csdnaokdm/FOC/选型报告/电容封装与直流偏压选型参考.md

# 电容封装与直流偏压选型参考

**适用场景**　FOC 底板的 3.3 V、5 V、12 V 电源。15 V 用作母线偏压对比工作点。

## 常见容值从什么封装起选

**0603 优先用于 pF 到 100 nF 的小电容和高频旁路，0805 优先用于 12 V 上的 1 µF，以及 3.3 V、5 V 上的几 µF 去耦。** 12 V 上若要得到接近 10 µF 的有效容量，先比较 1206、1210 或多颗并联的方案。表里的封装是选型起点，每个具体料号仍要按工作偏压读曲线。

| 标称容值 | 3.3 V / 5 V 上的常用起点 | 12 V 母线及 15 V 参考点的常用起点 | 主要用途与选型重点 |
|---|---|---|---|
| **10–100 pF** | 0603 C0G/NP0 | 0603 C0G/NP0，另核耐压和瞬态 | 晶振负载、精密滤波、匹配。容量随电压和温度变化很小 |
| **220 pF–10 nF** | 0603 C0G 或 X7R | 0603，耐压或容量规格难找时看 0805 | ADC 输入 RC、信号滤波。截止频率或相位有精度要求时优先 C0G |
| **22–100 nF** | 0603 X7R | 0603 X7R，50 V 型号可作起点 | 芯片脚旁高频旁路。100 nF / 50 V 的 C1591 在 12 V 下仍约有 93 nF |
| **220–470 nF** | 0603 X7R/X5R | 0603 或 0805 X7R，优先找有曲线的型号 | 局部去耦与自举候选。自举按电容两端的差分电压和所需电荷选值 |
| **1 µF** | 0603 可先筛，需接近 1 µF 时看 0805 | **0805 X7R 起选**。C28323 在 12 V 下约有 0.85 µF | 局部去耦、自举或多颗并联。相同的 1 µF / 50 V 标称值也可能有很不同的减容 |
| **2.2–4.7 µF** | 0805 X7R/X5R 起选。0603 可用于允许减容的局部去耦 | 0805 按型号筛。若有效容量有明确下限，优先比较 1206 或并联 | 稳压输入、负载旁路。项目旧料 2.2 µF / 0603 在 5 V 下约剩 1.03 µF，在 12 V 下约剩 0.40 µF |
| **10 µF** | 0805 可用于允许一定减容的就近去耦。若需要接近标称值，比较 1206、1210 或并联 | **1206 / 1210 起选并核曲线**。本次核过的两颗 50 V 0805 单颗在 12 V 下约为 2.6–2.8 µF | 电源局部储能、MOS 桥旁滤波。耐压相同也要比较工作点容量 |
| **22–47 µF** | 1206 / 1210 起选。稳压输出需同时满足有效容量和 ESR 要求 | 1210、较大封装或多颗并联，按偏压、纹波和温升选 | Buck 输出和较低频储能。大标称值的 0603/0805 需要型号曲线支持 |
| **100–470 µF 及以上** | 看铝电解、聚合物或合适的钽电容 | 母线大容量储能通常用铝电解，功率桥附近另布陶瓷滤波 | 按耐压、ESR、纹波电流、寿命、极性和实物尺寸选 |

0603、0805、1206、1210 在本文均为英制封装，分别约 **1.6 × 0.8、2.0 × 1.25、3.2 × 1.6、3.2 × 2.5 mm**。厚度和端头尺寸按所选型号核对。较小封装可缩短高频回路，较大封装通常有更多实现有效容量的空间。最终同时看容量、阻抗和走线。 [三星 MLCC 规格目录](https://product.samsungsem.com/resources/file/product-catalog/MLCC_2401.pdf) · [TI 陶瓷电容选型与纹波](https://www.ti.com/document-viewer/lit/html/SSZTBI6)

## 原厂曲线对比

下表是单颗典型有效容量，单位均为 **µF**，按 `标称容量 × (1 + ΔC% / 100)` 换算。曲线基于约 25°C 的数据。已有项目曲线按数据点插值，三星新增 10 µF / 0805 按图读数，村田按 SimSurfing 曲线换算。曲线读数尚需叠加初始容差、实际温度、老化和测量条件。5 V 输出的 22 µF 料使用 120 Hz、0.5 Vrms 曲线，其余三星样例为 1 kHz、1 Vrms，村田曲线显示 25°C、1 Vrms。

| 标称值 / 封装 / 介质 / 耐压 | 厂家型号与立创编号 | 3.3 V | 5 V | 12 V | 15 V |
|---|---|---:|---:|---:|---:|
| 100 nF / 0603 / X7R / 50 V | 三星 [CL10B104KB8NNNC](https://product.samsungsem.com/mlcc/CL10B104KB8NNN.do) · C1591 | 0.101 | 0.100 | 0.093 | 0.089 |
| 1 µF / 0603 / X5R / 50 V | 三星 [CL10A105KB8NNNC](https://product.samsungsem.com/mlcc/CL10A105KB8NNN.do) · C15849 | 0.816 | 0.656 | 0.290 | 0.218 |
| 1 µF / 0805 / X7R / 50 V | 三星 [CL21B105KBFNNNE](https://product.samsungsem.com/mlcc/CL21B105KBFNNN.do) · C28323 | 0.998 | 0.975 | **0.853** | 0.796 |
| 2.2 µF / 0603 / X5R / 25 V | 三星 [CL10A225KA8NNNC](https://product.samsungsem.com/mlcc/CL10A225KA8NNN.do) · C57895 | 1.442 | 1.026 | 0.395 | 0.295 |
| 2.2 µF / 1206 / X7R / 50 V | 三星 [CL31B225KBHNNNE](https://product.samsungsem.com/mlcc/CL31B225KBHNNN.do) · C50254 | 2.218 | 2.173 | 1.911 | 1.786 |
| 4.7 µF / 1206 / X7R / 50 V | 三星 [CL31B475KBHNNNE](https://product.samsungsem.com/mlcc/CL31B475KBHNNN.do) · C51205 | 4.698 | 4.546 | 3.720 | 3.338 |
| 10 µF / 0805 / X5R / 50 V | 村田 [GRM21BR61H106KE43L](https://item.szlcsc.com/439567.html) · C440198 | 8.00 | 6.41 | **2.62** | 2.04 |
| 10 µF / 0805 / X5R / 50 V | 三星 [CL21A106KBYQNNE](https://product.samsungsem.com/mlcc/CL21A106KBYQNN.do) · C2932476 | — | — | **约 2.8** | 约 2.2 |
| 10 µF / 1206 / X7R / 50 V | 三星 [CL31B106KBHNNNE](https://product.samsungsem.com/mlcc/CL31B106KBHNNN.do) · C89632 | 9.625 | 8.505 | 4.646 | 3.644 |
| 10 µF / 1210 / X7R / 50 V | 三星 [CL32B106KBJNNNE](https://product.samsungsem.com/mlcc/CL32B106KBJNNN.do) · C138687 | 9.790 | 9.393 | **7.413** | 6.553 |
| 22 µF / 1206 / X5R / 25 V | 三星 [CL31A226KAHNNNE](https://product.samsungsem.com/mlcc/CL31A226KAHNNN.do) · C12891 | 17.485 | 13.648 | 5.729 | 4.251 |
| 22 µF / 1210 / X5R / 25 V | 三星 [CL32A226KAJNNNE](https://product.samsungsem.com/mlcc/CL32A226KAJNNN.do) · C52306 | 20.387 | **17.486** | 8.946 | 6.924 |

同是 **10 µF / 50 V**，12 V 偏压下村田 0805 约剩 **26%**，三星 1210 约剩 **74%**。两颗该村田 0805 并联也只有约 **5.24 µF**。按 12 V 的典型容量对比，三颗约 **7.86 µF**，到 15 V 时三颗约 **6.13 µF**。若把 C138687 当作对照，应按实际工作电压分别比较，并留出容差与温度裕量。 [村田原厂 SimSurfing 曲线](https://ds.murata.com/simsurfing/mlcc.html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) · [三星 1210 原厂曲线](https://product.samsungsem.com/mlcc/CL32B106KBJNNN.do)

原始数据可查[项目已有型号的原厂曲线与计算记录](资料/2026-11-12_电容/本次确认与替代方案.json)和 [100 nF 曲线记录](资料/2026-11-12_电容/100nF_50V_C1591_原厂DC数据.json)。三星 50 V 0805 的 [立创商品页](https://www.lcsc.com/product-detail/C2932476.html)可核对完整型号。

## 各类电容的特性

| 类型 | 电气与使用特性 | 适合的位置 |
|---|---|---|
| **C0G / NP0 陶瓷** | 无极性，低损耗，直流偏压和老化对容量的影响很小。C0G 的常见温度系数规格为 0 ±30 ppm/°C。常见小封装容量集中在 pF 到 nF 级 | 晶振、精密 RC、滤波和匹配 |
| **X7R 陶瓷** | 无极性，体积小，ESR 和 ESL 通常较低。温度特性为 −55～125°C、相对基准容量 ±15%。工作时还要计入直流偏压和老化 | 12 V 母线旁路、驱动自举、靠近发热器件的电源去耦 |
| **X5R 陶瓷** | 无极性，常见高容值系列多。温度特性为 −55～85°C、±15%。直流偏压下的容量由型号曲线决定 | 3.3 V、5 V 去耦和空间受限的电源滤波 |
| **X6S、Y5V 等高介电陶瓷** | X6S 为 −55～105°C、±22%，Y5V 的温度容量变化范围更宽。可做出较大标称容值，选型时需同时看温度曲线和偏压曲线 | 允许容量变化、且原厂曲线满足电路下限的旁路或储能 |
| **固体钽（MnO₂）** | 有极性，容量密度高，偏压变化通常较小。ESR 取决于系列，对反接、浪涌和过压敏感，按厂商规则降额 | 有输出电容类型或 ESR 要求的 LDO。本板 3.3 V 输出选 22 µF / 10 V A 型钽 **C11366**，按 LDO 手册和实测确认稳定性。 [UMW 手册](https://atta.szlcsc.com/upload/public/pdf/source/20241218/BAF0263FA2E44BCD8AF41AA4FA04EFAA.pdf) |
| **铝电解** | 通常有极性。大容量容易取得。ESR 随频率、温度和寿命变化，纹波电流引起自热。额定纹波需按测试频率及温度修正 | 12 V 入口和母线储能。本板使用 100 µF / 35 V **C2887272** 与 470 µF / 35 V **C72519** |
| **导电聚合物铝电解或钽电容** | 常用贴片型号有极性，通常具有更低 ESR 和较好的纹波能力。需核对耐压、漏电和稳压器对 ESR 的要求 | 低阻抗储能、开关电源输出和较大负载阶跃。 [Panasonic OS-CON 系列](https://industrial.panasonic.com/ww/products/pt/os-con/lineup) |
| **薄膜电容** | 多数无极性，低损耗，容量随偏压变化小，体积通常较大。不同介质的脉冲和温度特性不同 | 脉冲、谐振和需要容量稳定的场合。 [WIMA 薄膜介质特性](https://www.wima.de/en/service/knowledge-base/dielectric/) |

介质温度代码描述规定条件下的温度变化。初始容差、工作偏压、老化和交流测试幅度需要单独核对。ESR 影响纹波和自热，ESL 与布局决定高频阻抗。靠近 MOS 桥或 Buck 的陶瓷电容要缩短供电和回地之间的高频回路。 [村田陶瓷类型说明](https://www.murata.com/en-global/support/faqs/capacitor/ceramiccapacitor/char/0017) · [TDK 温度代码](https://product.tdk.com/en/contact/faq/capacitors-0051.html) · [KYOCERA AVX TAJ 系列](https://www.kyocera-avx.com/products/tantalum/smd-tantalum-mno2/taj-series/) · [Nichicon 铝电解应用指南](https://www.nichicon.co.jp/english/products/pdf/aluminum-e.pdf) · [TI 电源电容阻抗和布局](https://www.ti.com/document-viewer/lit/html/ssztal7)

## 以后选料时怎么核算

1. 先看芯片手册或电路计算所需的有效容量、ESR 和纹波条件。Buck 输入、Buck 输出和 LDO 输出各自核对。
2. 用电容两端的实际直流电压查完整料号。自举电容按 `VBx−VSx`，12 V 母线按实际母线偏压，耐压另计尖峰和使用温度。
3. 先对比厂家曲线的典型值，再按初始容差、温度、老化等条件预留余量。并联时，同一偏压下的有效容量相加，纹波分担取决于器件阻抗和布局。
