csdnaokdm/FOC/选型报告/选型报告.md

# FOC 硬件选型报告

**阿波罗 H7 V2.5 核心板 · 2804 电机 · 12 V 台架**  
更新：2026-11-12

本报告按使用位置和器件类别整理当前方案。电容用“12 V→5 V 输入”“5 V 输出”“MOS 母线滤波”等位置描述；表中的商城采购编号用于买料，与原理图位号分开。当前记录的电源条件是 **12 V**，后面的 **15 V 只作为电容减容参考工作点**。

采购状态分为“已确认”“本次推荐”和“待确认”。本次更新整理选型与采购信息，未操作原理图、PCB 和封装。旧方案与旧料号对比见[历史料号](历史料号.md)，原报告全文保存在[历史方案 v0.4](历史方案_2026-11-05_v0.4.md)。

## 1. 芯片

### 1.1 电源芯片

| 使用位置 | 当前型号与采购编号 | 主要参数 | 国内含税首档单价 / 起卖量 | 状态与落实事项 |
|---|---|---|---|---|
| 12 V→5 V 降压 | **TI LMR51430XDDCR**；[C5185863](https://item.szlcsc.com/5856347.html) | 同步 Buck；输入 4.5–36 V；标称输出能力 3 A；500 kHz；SOT-23-6 | **¥4.79/个；1 个起卖**；最低货款 ¥4.79；查询时现货 7,676 个 | 当前原理图已使用。实际连续输出能力需结合电感、电容、铜皮散热和负载确认 |
| 5 V→3.3 V 线性稳压 | **UMW（友台）AMS1117-3.3**；[**C347222**](https://item.szlcsc.com/323882.html) | 固定 3.3 V LDO；标称 1 A；SOT-223；1 A 时压差典型 1.2 V、最大 1.3 V；−40～125°C | **¥0.2971/个；10 个起卖**；最低货款约 ¥2.97；100+ ¥0.235，300+ ¥0.203；现货 894,290 个 | 用户已确认采购编号。原理图已使用 AMS1117-3.3 名称，具体采购参数尚需填入；实际电流能力取决于散热，功耗按 (5−3.3)×负载电流估算 |

12 V→5 V 输入的陶瓷电容按已确认方案采用 **两颗 1 µF / 50 V / 0805 并联**。相应的有效容量和采购信息见第 2 节。

3.3 V 稳压器已按用户补充的 **C347222** 核定为 UMW 产品。[UMW 原厂手册第 4～5 页](https://atta.szlcsc.com/upload/public/pdf/source/20241218/BAF0263FA2E44BCD8AF41AA4FA04EFAA.pdf)要求输出电容以保证稳定性，并给出 **22 µF 钽电容**配置，固定输出典型电路为输入 10 µF、输出 22 µF。因此本报告推荐的 **22 µF / 10 V / A 型钽电容**有对应厂家手册依据。布局时还需按输入 10 µF 的参考配置核对 LDO 就近输入储能和连接路径；5 V 输出已有大容量电容能否兼作输入储能，取决于实际位置与走线。该输入要求属于 5 V→3.3 V 级。

### 1.2 栅极驱动与控制相关芯片

| 使用位置 | 当前型号 | 当前状态 | 采购与核对事项 |
|---|---|---|---|
| 三相桥栅极驱动 | **SD6287** | 当前原理图已放置；符号记录为 TSSOP-20 | 厂家、完整后缀、采购编号、价格及起卖量待确认。需用实际器件手册核对供电、输入逻辑、欠压行为、自举要求和引脚 |
| 主控 | **正点原子阿波罗 H7 V2.5 核心板** | 已有核心板，底板按接口对接 | 核对实物版本、核心板连接器和电源引脚；不把旧报告中的单颗 MCU 预算作为本次采购项 |
| 电机角度检测 | **现有 AS5600 编码器/模块** | 保留已有器件作为调试方案 | 模块供电、输出接口及接插件线序按实物确定；本次未新增编码器芯片采购 |

三相桥 MOSFET 已由用户选定为 AOS AOD4184A（C99124），详见第 4 节。电流采样放大器及硬件保护器件的选型待落实。

## 2. 电容

### 2.1 按使用位置列出的当前选型

| 使用位置 | 容值 / 耐压 / 封装 / 类型 | 厂家完整型号 | 商城采购编号 | 每板数量与状态 |
|---|---|---|---|---|
| **12 V→5 V 输入** | **1 µF / 50 V / 0805 / X7R / ±10%** | Samsung **CL21B105KBFNNNE** | [**C28323**](https://item.szlcsc.com/29074.html) | **2 颗并联，用户已确认**；合计标称 2 µF |
| **三相栅极驱动自举** | **1 µF / 50 V / 0805 / X7R / ±10%** | Samsung **CL21B105KBFNNNE** | [**C28323**](https://item.szlcsc.com/29074.html) | 每相 1 颗，共 3 颗；共用同一种料。最终容量要求随 SD6287 实际手册核对 |
| **MOS 母线滤波，靠近功率桥** | **10 µF / 50 V / 1210 / X7R / ±10%** | Samsung **CL32B106KBJNNNE** | [**C138687**](https://item.szlcsc.com/150006.html) | **本次推荐**；你已允许 MOS 区域用 1210。颗数随三相桥布局确定，暂不虚列数量 |
| **5 V 输出** | **22 µF / 25 V / 1210 / X5R / ±10%** | Samsung **CL32A226KAJNNNE** | [**C52306**](https://item.szlcsc.com/53320.html) | **本次推荐 2 颗并联**，合计标称 44 µF；需为 1210 落实焊盘和空间 |
| **5 V→3.3 V 稳压器的 3.3 V 输出** | **22 µF / 10 V / A 型 3216 / 有极性固体钽 / ±10%** | KYOCERA AVX **TAJA226K010RNJ** | [**C11366**](https://item.szlcsc.com/11919.html) | **本次推荐，1 颗**。与 UMW 手册的 22 µF 钽电容类型和标称容量一致；具体 ESR、上电和负载阶跃稳定性仍需核对 |
| **12 V 电源入口储能** | **100 µF / 35 V / Ø6.3×5.4 mm / 铝电解 / ±20%** | KNSCHA 科尼盛 **VT100UF35V34RV0158** | [**C2887272**](https://item.szlcsc.com/3103840.html) | **保留，2 颗**。纹波额定值 90 mA @120 Hz；实际开关纹波能力另核 |
| **12 V 母线大容量储能** | **470 µF / 35 V / Ø10×10.2 mm / 铝电解 / ±20%** | ROQANG 容强 **RVT1V471M1010** | [**C72519**](https://item.szlcsc.com/73630.html) | **保留，2 颗**。纹波额定值 286 mA @120 Hz；105°C、2000 h |
| **电源高频旁路与 Buck 自举参考用料** | **100 nF / 50 V / 0603 / X7R / ±10%** | Samsung **CL10B104KB8NNNC** | [**C1591**](https://item.szlcsc.com/1943.html) | **可追溯的通用参考料，不要求额外采购**。已有 100 nF 可继续按具体型号、耐压和工作点核对 |

1 µF 目前明确的用量合计 **5 颗/板**：降压输入 2 颗、三相驱动自举 3 颗。驱动电源最终需要的额外旁路，待实际驱动器手册确定后再计入。

铝电解用于储能和较低频率的母线纹波，靠近功率桥的陶瓷电容用于减小高频换流回路。两类电容的布局和纹波要求分别核对。钽电容必须按正负极及专用焊盘安装，A 型 3216 不能仅凭外形尺寸套用普通无极性陶瓷电容焊盘。

### 2.2 在本板工作电压下，实际约剩多少容量

下列陶瓷电容数值来自 **Samsung 对应型号的原厂典型 DC 偏压曲线**，按工作电压插值。它们是常温、小信号条件下的典型参考值；尚未叠加初始容差、温度、老化和批次差异，也不是保证下限。并联总容量按相同工作电压下的单颗典型值相加。

| 使用位置与选型 | 电容两端的直流电压 | 单颗典型有效容量 | 相对标称的变化 | 本位置典型总有效容量 |
|---|---:|---:|---:|---:|
| **12 V→5 V 输入：1 µF / 50 V / 0805 / X7R，C28323** | **12 V** | **约 0.853 µF** | **下降约 14.70%** | **2 颗约 1.706 µF** |
| 同一降压输入选型，15 V 参考工作点 | **15 V** | **约 0.796 µF** | **下降约 20.38%** | **2 颗约 1.592 µF** |
| **三相驱动自举：1 µF / 50 V / 0805 / X7R，C28323** | 自举电容两端若为 **12 V** | **约 0.853 µF** | **下降约 14.70%** | 每相各约 0.853 µF，三相不相加作为同一相容量 |
| **MOS 母线滤波：10 µF / 50 V / 1210 / X7R，C138687** | **12 V** | **约 7.413 µF** | **下降约 25.87%** | 按最终并联颗数乘以 7.413 µF |
| 同一 MOS 母线滤波选型，15 V 参考工作点 | **15 V** | **约 6.553 µF** | **下降约 34.47%** | 按最终并联颗数乘以 6.553 µF |
| **5 V 输出：22 µF / 25 V / 1210 / X5R，C52306** | **5 V** | **约 17.486 µF** | **下降约 20.52%** | **2 颗约 34.971 µF** |
| **3.3 V 输出推荐：22 µF / 10 V / A 型钽，C11366** | **3.3 V** | **本次未取得该具体型号的偏压有效容量数值** | 不套用陶瓷电容的减容百分比 | 按标称 22 µF、±10% 选型，与已核 UMW 手册的钽电容配置一致；手册未给数值 ESR 稳定窗口，具体型号的稳定性仍需实测 |
| **12 V 入口储能：100 µF / 35 V / 铝电解，C2887272** | **12 V** | 本次未取得该型号工作点实测值 | 不套用 X5R/X7R 陶瓷曲线 | 2 颗合计标称 200 µF；还需计入 ±20% 容差、温度、频率及寿命影响 |
| **12 V 母线储能：470 µF / 35 V / 铝电解，C72519** | **12 V** | 本次未取得该型号工作点实测值 | 不套用 X5R/X7R 陶瓷曲线 | 2 颗合计标称 940 µF；还需计入 ±20% 容差、温度、频率及寿命影响 |

降压输入按两颗 1 µF 执行时，**标称总容量是 2 µF，12 V 下典型约 1.71 µF**。这项方案已按你的要求记录；是否满足实际输入纹波和瞬态要求，仍需结合 TI 手册、输入线路及板上测量确认。5 V 输出的 22 µF 选型按 **5 V 工作点**使用，后续换位置时要重新核算偏压。

自举电容计算的是 **自举上端与对应开关相点之间的电压**，不能直接用该上端相对地的波形电压代替。三相驱动器最终供电确定后再核实际工作点；Buck 的 100 nF 自举也按同样的差分电压原则核对。

### 2.3 100 nF 常用电容也会减容吗

**会，X5R/X7R 陶瓷电容同样存在 DC 偏压效应。** 下降多少取决于具体型号。以本报告可追溯的 **100 nF / 50 V / 0603 / X7R，C1591** 为例：

| 使用位置示例 | 两端直流电压 | 典型有效容量 | 相对标称变化 |
|---|---:|---:|---:|
| 3.3 V 高频旁路 | 3.3 V | 约 **101.07 nF** | 约 **+1.07%** |
| 5 V 高频旁路 | 5 V | 约 **100.24 nF** | 约 **+0.24%** |
| 12 V 电源高频旁路 | 12 V | 约 **93.03 nF** | 约 **−6.97%** |
| 15 V 参考工作点 | 15 V | 约 **88.96 nF** | 约 **−11.04%** |

这款 100 nF 在上述工作点的减容较小。现有散装或其他型号的 100 nF，需要知道厂家和型号后才能套用对应结论；仅有“104”字样不能确定减容程度。

**耐压与偏压是两个参数。** “耐压 10 V”表示器件的额定电压；“5 V 偏压”表示使用时电容两端长期加了 5 V 直流。工作电压在额定范围内时，X5R/X7R 的有效容量仍可能下降。判断是否满足电路需要，要同时看耐压和这个工作点的有效容量。

**不同封装的相同标称容量，也可能有不同的有效容量、ESR、ESL、纹波温升和高度。** 较大封装能给低减容设计提供空间，但不能只按“1210 大于 1206”推定具体百分比；本报告按完整型号的曲线选择。高频旁路还要关注焊盘和回流路径长度。X7R 的温度等级通常到 125°C，X5R 到 85°C；X7R 这个名称本身不保证比所有 X5R 型号减容少。

### 2.4 电容价格、起卖量与首单金额

以下均为 **2026-11-12 国内立创商城含税页面快照，人民币/颗，未含运费，未叠加满减券**。MOQ 为商品详情的最小起订量；购买倍数和最终结算以实际下单页面为准。促销价和库存会变。

| 对应位置 / 完整规格与采购编号 | 含税首档单价 | 起卖量 MOQ | 按 MOQ 的最低货款 | 其他已核价格档 / 查询时库存 |
|---|---:|---:|---:|---|
| 降压输入、驱动自举：**1 µF / 50 V / 0805 / X7R，C28323** | **¥0.1853** | **10 颗** | **约 ¥1.85** | 100+ ¥0.1392；300+ ¥0.1187；2000+ ¥0.1033；现货 |
| MOS 母线滤波：**10 µF / 50 V / 1210 / X7R，C138687** | **¥1.9351** | **1 颗** | **约 ¥1.94** | 10+ ¥1.5190；30+ ¥1.3158；100+ ¥1.1346；现货 16,854 颗 |
| 5 V 输出：**22 µF / 25 V / 1210 / X5R，C52306** | **¥1.4250** | **2 颗** | **¥2.85** | 20+ ¥1.1197；60+ ¥0.9707；200+ ¥0.8377；现货 119,642 颗 |
| 3.3 V 输出推荐：**22 µF / 10 V / A 型钽，C11366** | **¥1.1327** | **1 颗** | **约 ¥1.13** | 10+ ¥0.8809；30+ ¥0.7579；100+ ¥0.6483；现货 388,285 颗 |
| 12 V 入口储能：**100 µF / 35 V / Ø6.3×5.4 mm / 铝电解，C2887272** | **¥0.2464**，当前 8.8 折；原价 ¥0.28 | **10 颗** | **约 ¥2.46** | 现货 82,280 颗 |
| 12 V 母线储能：**470 µF / 35 V / Ø10×10.2 mm / 铝电解，C72519** | **¥0.474812**，当前 9.2 折；原价 ¥0.5161 | **5 颗** | **约 ¥2.37** | 现货 42,480 颗 |
| 可选通用料：**100 nF / 50 V / 0603 / X7R，C1591** | **¥0.0428** | **100 颗** | **¥4.28** | 1000+ ¥0.0322；4000+ ¥0.0274；8000+ ¥0.0239；现货 140,700 颗；已有料不必为本方案重复采购 |

起卖量与每板用量分别列出。例如，1 µF 每板明确用 5 颗，但该商品 10 颗起卖；10 µF 的最终每板用量待功率桥布局确定，因此不汇总虚假的整板电容总价。

### 2.5 原厂曲线与计算资料

| 选型 | 原厂工作点曲线 | 曲线测试条件 |
|---|---|---|
| **1 µF / 50 V / 0805 / X7R，C28323** | [Samsung CL21B105KBFNNN](https://product.samsungsem.com/mlcc/CL21B105KBFNNN.do) | 25°C、1 kHz、1 Vrms |
| **10 µF / 50 V / 1210 / X7R，C138687** | [Samsung CL32B106KBJNNN](https://product.samsungsem.com/mlcc/CL32B106KBJNNN.do) | 25°C、1 kHz、1 Vrms |
| **22 µF / 25 V / 1210 / X5R，C52306** | [Samsung CL32A226KAJNNN](https://product.samsungsem.com/mlcc/CL32A226KAJNNN.do) | 25°C、120 Hz、0.5 Vrms |
| **100 nF / 50 V / 0603 / X7R，C1591** | [Samsung CL10B104KB8NNN](https://product.samsungsem.com/mlcc/CL10B104KB8NNN.do) | 25°C、1 kHz、1 Vrms |

本地计算与价格证据保存在[电容资料目录](资料/2026-11-12_电容/)中，包括[两颗 1 µF 输入的确认记录](资料/2026-11-12_电容/当前确认方案_两颗1uF输入.json)、[候选曲线与采购快照](资料/2026-11-12_电容/本次确认与替代方案.json)及[100 nF 原厂数据](资料/2026-11-12_电容/100nF_50V_C1591_原厂DC数据.json)。

## 3. 端子与连接器

本节按当前原理图列出，价格口径同第 2.4 节。

| 使用位置 | 型号与采购编号 | 规格 / 每板数量 | 国内含税首档价、起卖量及最低货款 | 状态与待核对事项 |
|---|---|---|---|---|
| **12 V 电源输入** | **XT30UPB-M**；采购编号待绑定 | 板载电源连接器；1 个 | **价格、MOQ 待确认** | 当前符号使用该名称，需核对实际厂家完整型号、焊盘、方向和线端配对件 |
| **4 线编码器 / I²C 接口** | 莱联 **LAIL-PHC1.25-4P-01-GH-WT**；[**C54905900**](https://item.szlcsc.com/58431077.html) | GH 类 1×4P、1.25 mm、卧贴；1 A / 50 V；−25～85°C；辅助焊脚；1 个 | **¥0.9687/个，5 个起卖，约 ¥4.84** | 现货 58,110 个；核线序、锁扣方向与配套线束，不能只按 GH 名称判断互配 |
| **6 线编码器 / SPI 接口** | 首韩 **SH-GH1.25-6PWB**；[**C42372473**](https://item.szlcsc.com/44255911.html) | GH 类 1×6P、1.25 mm、卧贴；1 A / 125 V；−25～85°C；1 个 | **¥0.377625/个，10 个起卖，约 ¥3.78** | 现货 23,610 个；核实际针脚顺序、配套线束和机械尺寸 |
| **H7 核心板连接座** | **3710F60037G0FR01**；**C9900157213** | 60P、间距 0.8 mm；2 个 | **本轮未核到国内商品页，价格与 MOQ 未确认** | 当前库的安装方式字段与封装命名存在差异，需拿实物/原厂图确认安装方式、插合高度与定位尺寸 |
| **电机 U / V / W 输出** | **尚未在当前三张图中完成选型** | 电流、线径、安装方式待确定 | 待选型 | 旧版端子信息见历史料号；定版时随实际电机电流和板上空间选择 |

## 4. 电感、电阻与其他器件

| 使用位置 | 当前选型 / 主要参数 | 采购信息 | 状态 |
|---|---|---|---|
| **12 V→5 V Buck 储能电感** | 顺络 **MWSA0603S-6R8MT**；**6.8 µH ±20%**；额定 5 A、饱和 6 A；DCR 48 mΩ；约 7×6.6 mm | [**C408449**](https://item.szlcsc.com/397801.html)；国内含税 **¥0.6549/个，5 个起卖，约 ¥3.27** | 查询时现货 0，需订货；最终按负载峰值及温升核对。“0603S”是该系列名称的一部分，不能按 0603 电容尺寸理解 |
| **5 V 输出反馈上臂** | **100 kΩ、±1%** | 完整厂家型号、采购编号及价格待绑定 | 随 13.7 kΩ 下臂核对输出设定值 |
| **5 V 输出反馈下臂** | **13.7 kΩ、±1%、0603 电阻**；采购编号 **C22793** | 已找到采购参考编号；原理图尚未填入供应商参数，本轮未追加价格核实 | 这是电阻；放在本节，避免混进电容采购清单 |
| **三相桥 MOSFET** | **AOS AOD4184A**，N 沟道，**40 V / TO-252（DPAK）**，VGS 极限 ±20 V，完整三相桥 **6 颗/板** | [**C99124**](https://item.szlcsc.com/100337.html)。2026-11-11 用户提供的国内含税参考价为 **¥2.0859/颗（5+ 档）**，6 颗用料约 **¥12.52**。实际采购金额按下单数量及结算价计算 | **用户已确认**。当前保存的 MOSDriver.SchDoc 已有 2 颗绑定 C99124，其余桥臂随原理图完善 |
| **电流采样与硬件保护** | 当前图尚未形成完整方案 | 待选型 | 采样量程、放大倍数、比较门限与故障关断逻辑需一起落实 |

**AOD4184A 工作点。** 原厂给出的最大导通电阻为 7 mΩ（VGS = 10 V、25°C）、9.5 mΩ（VGS = 4.5 V、25°C）及 12 mΩ（VGS = 10 V、结温 125°C）。10 V 下总栅极电荷典型 27 nC、最大 33 nC。单管流过 2 A 时，按 7 mΩ 估算导通损耗约 28 mW。手册中的连续漏极电流 50 A 对应封装壳温 25°C，13 A 对应 25°C 环境与规定的 PCB 散热条件。样板在换相、减速和高占空比下核对 VDS 尖峰、上下管 VGS 和温升。TO-252 的漏极大焊盘按原厂封装图核对。 [AOS 原厂手册](https://www.aosmd.com/sites/default/files/res/datasheets/AOD4184A.pdf)

## 5. 资料、历史记录与落实边界

- 前次电容与连接复核的原理图基线见[源文件清单](../审查报告/2026-11-12_电容与连接复核/source_manifest.json)。本次 MOS 选型状态依据当前保存的 MOSDriver.SchDoc。
- 芯片与已有器件的本地资料见[资料索引](资料/资料索引.md)；LMR51430 的规格与使用条件可查 [TI 原厂页面](https://www.ti.com/product/LMR51430)。
- [历史料号](历史料号.md)：旧电容及候选的减容对比、旧芯片架构和旧端子方案。
- [历史方案 v0.4 全文](历史方案_2026-11-05_v0.4.md)：保留 2026-11-05 的原报告，包含当时的电机资料、调试顺序、布局建议和旧 BOM。

待落实的选型重点是：SD6287 的确切厂家/型号、UMW AMS1117 采购参数写入与 LDO 就近输入储能配置、3.3 V 输出的上电及负载阶跃稳定性、MOS 母线陶瓷电容数量、1210 电容焊盘及连接器配对尺寸。电容有效值属于选型计算证据；整板供电、原理图连接、原生 Compile/ERC、PCB DRC、纹波与温升仍需分别验证。
