csdnaokdm/FOC/选型报告/历史料号.md

# 历史料号与候选记录

更新：2026-11-12

这里保存旧方案和未进入当前采购表的候选。当前使用位置、选定规格、价格与减容数据见[选型报告](选型报告.md)。2026-11-05 原报告的完整内容保存在[历史方案 v0.4](历史方案_2026-11-05_v0.4.md)，本文件只提取与当前选型有关的变化。

## 1. 电容：原有料号和候选的处理记录

下面的采购编号均为商城编号。功能位置用于说明用途，不使用原理图电容位号。有效容量是对应型号的原厂典型 DC 偏压曲线参考值，不是保证下限；没有取得准确曲线的型号明确记为未知。

| 原用途 / 候选用途 | 完整规格、厂家型号与采购编号 | 工作点有效容量与变化 | 当前处理 |
|---|---|---|---|
| 12 V→5 V 输入旧料 | **2.2 µF / 25 V / 0603 / X5R**；Samsung **CL10A225KA8NNNC**；**C57895** | **12 V 约 0.395 µF，下降约 82.03%** | 退出当前输入采购；按用户确认采用两颗 1 µF / 50 V / 0805 / X7R 并联，详见主报告 |
| 5 V / 3.3 V 输出旧陶瓷料 | **22 µF / 10 V / 0603 / X5R**；Chinocera **HGC0603R5226M100NTHJ**；**C7432770** | 本次未取得该确切型号在 **5 V、3.3 V** 下的有效容量曲线 | 按用户“曲线查不到则换可核型号”的要求退出当前采购；未知不等于已经证明它容量不够 |
| 原先报给的 47 µF 料 | **47 µF / 16 V / 1206 / X5R**；FH **1206X476M160NT**；**C172351** | 当前未找到在本板已使用的位置；未取得确切工作点曲线 | 不额外加入当前采购；后续有具体位置再核算 |
| 12 V MOS 母线低单价旧候选 | **10 µF / 50 V / 1206 / X5R**；Samsung **CL31A106KBHNNNE**；[**C13585**](https://item.szlcsc.com/14236.html) | **12 V 约 3.386 µF，下降约 66.14%**；15 V 约 2.548 µF，下降约 74.52% | 超过用户约 50%～60% 的换料界限，退出当前推荐 |
| 12 V MOS 母线另一旧候选 | **10 µF / 50 V / 1206 / X7R**；Samsung **CL31B106KBHNNNE**；[**C89632**](https://item.szlcsc.com/90812.html) | **12 V 约 4.646 µF，下降约 53.54%**；15 V 约 3.644 µF，下降约 63.56% | 按用户减容界限换成主报告的 10 µF / 50 V / 1210 / X7R |
| 12 V 输入 / 驱动自举小封装旧候选 | **1 µF / 50 V / 0603 / X5R**；Samsung **CL10A105KB8NNNC**；[**C15849**](https://item.szlcsc.com/16531.html) | **12 V 约 0.290 µF，下降约 70.98%** | 退出当前推荐；主报告按 0805 的 1 µF 型号采购 |
| 1 µF 低价候选 | **1 µF / 50 V / 0603 / X5R**；Chinocera **HGC0603R5105K500NTHJ**；[**C7472958**](https://item.szlcsc.com/8532805.html) | 未取得确切 DC 偏压曲线 | 不进入当前推荐 |
| 10 µF 小封装候选 | **10 µF / 50 V / 0805 / X5R**；Murata **GRM21BR61H106KE43L**；[**C440198**](https://item.szlcsc.com/439567.html) | 本次未取得确切型号的 12 V 有效容量数值 | 不进入当前推荐；不能仅按标称 10 µF 计入母线容量 |
| 单颗 2.2 µF 低减容候选 | **2.2 µF / 50 V / 1206 / X7R**；Samsung **CL31B225KBHNNNE**；[**C50254**](https://item.szlcsc.com/51263.html) | **12 V 约 1.911 µF，下降约 13.11%** | 用户已确认输入用两颗 1 µF，并明确不单买 2.2 µF；本料只留历史记录 |
| 输入加大容量的旧候选 | **4.7 µF / 50 V / 1206 / X7R**；Samsung **CL31B475KBHNNNE**；[**C51205**](https://item.szlcsc.com/52218.html) | **12 V 约 3.720 µF，下降约 20.86%** | 不加入当前输入采购；输入按两颗 1 µF 执行 |
| 5 V 输出较小封装候选 | **22 µF / 25 V / 1206 / X5R**；Samsung **CL31A226KAHNNNE**；[**C12891**](https://item.szlcsc.com/13537.html) | **5 V 约 13.648 µF，下降约 37.96%** | 没有达到用户 50%～60% 换料界限，仍可作为空间受限时的候选。本次主报告选择 1210、5 V 下约 17.486 µF 的型号，减容更少且首单金额更低 |

当前继续保留的 **100 µF / 35 V 铝电解，C2887272** 与 **470 µF / 35 V 铝电解，C72519** 已放在主报告，后续按具体纹波和布局核对。原先一起报给的 **C22793** 实际是 **13.7 kΩ / ±1% / 0603 电阻**，已归入主报告的反馈电阻部分。

### 1.1 旧候选价格快照

这些价格仅用于还原当时的比较，**不构成当前采购清单**。日期均为 2026-11-12，人民币/颗，未含运费。税口径未核实的项目不标为已含税。

| 旧候选完整规格与采购编号 | 首档单价 / MOQ | 按 MOQ 货款 | 税口径 / 查询时状态 |
|---|---:|---:|---|
| **10 µF / 50 V / 1206 / X5R，C13585** | ¥0.7763 / 10 颗 | 约 ¥7.76 | 税口径未单独确认；当时现货 90 颗，另有在途 |
| **10 µF / 50 V / 1206 / X7R，C89632** | ¥1.2982 / 5 颗 | 约 ¥6.49 | 已确认含税；现货 |
| **1 µF / 50 V / 0603 / X5R，C15849** | ¥0.0685 / 50 颗 | 约 ¥3.43 | 税口径未单独确认；无现货、可订货 |
| **1 µF / 50 V / 0603 / X5R，C7472958** | ¥0.050445 / 50 颗 | 约 ¥2.52 | 税口径未单独确认；当时 95 折活动价、现货 |
| **10 µF / 50 V / 0805 / X5R，C440198** | ¥0.7845 / 5 颗 | 约 ¥3.92 | 税口径未单独确认；现货 |
| **2.2 µF / 50 V / 1206 / X7R，C50254** | ¥0.3723 / 10 颗 | 约 ¥3.72 | 已确认含税；现货 |
| **4.7 µF / 50 V / 1206 / X7R，C51205** | ¥0.4612 / 10 颗 | 约 ¥4.61 | 税口径未单独确认；现货 |
| **22 µF / 25 V / 1206 / X5R，C12891** | ¥0.6282 / 20 颗 | 约 ¥12.56 | 已确认含税；现货。当前主报告 1210 型号 2 颗起卖，首单 ¥2.85 |

原始证据见[国内价格与起订量](资料/2026-11-12_电容/国内价格与起订量.json)、[候选方案及原厂曲线](资料/2026-11-12_电容/本次确认与替代方案.json)、[原先六料号复核](资料/2026-11-12_电容/原先六料号复核.json)。

## 2. 芯片：2026-11-05 旧架构

| 功能 | 旧版型号或组合 | 与当前报告的关系 |
|---|---|---|
| 12 V→5 V Buck | **LMR51420XDDCR** | 旧版为 2 A 型号；当前原理图使用 **LMR51430XDDCR**，其现行采购信息在主报告 |
| 5 V→3.3 V LDO | **TLV75533PDBVR** | 旧版低压差方案；当前图使用 **AMS1117-3.3**，不能直接沿用旧 LDO 的输出电容要求 |
| 三相栅极驱动 | **DRV8300DPWR** | 旧版手焊方案；当前图使用 **SD6287**，供电与输入逻辑要按当前实际器件手册核对 |
| 5 V→约 10 V 栅极升压 | **TPS61040** | 旧版独立栅极供电架构的一部分，尚未作为当前图中的已确认芯片采购 |
| 三相桥 MOSFET | **6 颗 AO4266** | 旧版候选，尚未在当前图落实 |
| 三路电流采样放大 | **3 颗 INA181A1IDBVR** | 旧版候选，尚未在当前图落实 |
| 电流中点缓冲 | **TLV9001** | 旧版候选，随当前采样架构重新核对 |
| 外部比较器与硬件许可 | **TLV1704×2、SN74LVC08A×2** | 旧版关断设计，不能据此认定当前 SD6287 的关断极性、欠压行为或默认状态 |
| 编码器升级候选 | **AS5047P 模块** | 旧版高速有感控制升级选项；当前保留已有 AS5600，尚未新增采购 |

旧版约 18 美元的 BOM 合计属于 2026-11-05 当时的型号和价格快照，**不作为当前方案的人民币预算**。详细型号、来源、实验顺序与核算保留在[历史方案全文](历史方案_2026-11-05_v0.4.md)。

## 3. 端子与连接器：旧版方案

| 使用位置 | 旧版方案 | 当前处理 |
|---|---|---|
| 电源输入 | AMASS **XT30PW-M**；商城完整名称 **XT30PW-M30.G.Y**；**C431092** | 当前符号名为 **XT30UPB-M**。旧品不直接替换当前采购编号，先核机械形式和焊盘 |
| 电机 U / V / W 输出 | DEGSON **DG500-5.08-03P**；**C581322** | 作为历史候选；当前图尚未完成电机端子的落实，后续按电流、线径和安装空间选择 |

## 4. 旧报告中的电感、布局与调试资料

旧版 Buck 曾按 **10 µH 的 XAL5050 系列电感**核算；当前图记录为 **MWSA0603S-6R8MT、6.8 µH、C408449**，现行参数与供货状态已移到主报告。

旧报告的铜皮、采样、关断和调试建议与当时整套电路配套。保留原文便于查阅；当驱动器、电源与采样架构变化时，需以当前图和实际手册重新核对后再使用。
