csdnaokdm/FOC/选型报告/历史方案_2026-11-05_v0.4.md

# 2804 无刷电机驱动底板设计方案

**阿波罗 H7 V2.5 核心板 · 12 V 台架 · 从六步换向到有感 FOC**  
版本 v0.4 · 2026-11-05

## 1. 选型结论与设计边界

- **首版保留 AS5600。** 先用它做角度读取、六步换向和低速电流闭环。驱动底板同时预留 3.3 V 的 SPI 编码器接口。若目标是接近 1400 rpm 仍有较好的电流解耦和动态响应，优先准备 AS5047P 模块，并核对机械安装。
- **按电烙铁手焊选 DRV8300DPWR + 6 颗 AO4266 + 3 颗 INA181A1IDBVR。** 使用 TSSOP、SO-8、SOT-23 外露引脚。H7 发 6 路 PWM，外部比较器与逻辑门实现硬件许可。电阻电容以 0603 为起点，采样电阻用 2512。
- **电源采用独立 Buck。** 电机母线直接给三相桥和栅极驱动器。LMR51420 将母线降到 5 V，供 H7 核心板、底板 3.3 V LDO 和 TPS61040。TPS61040 升到约 10 V 供栅极驱动。底板的 3.3 V 与核心板的 3.3 V 不并联，共用地。
- **电源输入采用 AMASS XT30PW-M。** 选型编号 C431092，完整商城型号 XT30PW-M30.G.Y，板载通孔、卧式出线、公头，电源线端用相配母头。
- **首版按空载和轻载台架设计。** 这一条是设计假设。默认先用现有台式电源，电源规格、限流模式和回灌特性待确认。首版调试范围与电机额定工况分开定义。

| 项目 | 数据或初值 | 来源与含义 |
|---|---|---|
| 电机 | 2804、中空轴外转子、现有 AS5600 套件 | 用户提供的商品信息 |
| 电机标称参数 | 适用 7.4–16 V，额定 12 V / 1400 rpm，0.03 N·m，12 槽 14 极，7 极对 | 用户补充。0.03 N·m 对应的电流与工况待确认 |
| 主控 | 正点原子阿波罗 H7 V2.5，有核心板及原扩展板 | 自制底板替代原扩展板。MCU 完整丝印和核心板自身的修订号仍需核对 |
| 未确认的电机数据 | 额定电流、峰值电流、线间电阻和电感、绕组接法、空载 KV | 淘宝短链未打开。同类 2804 有不同绕组版本，本文未套用同类产品的电流参数 |
| 首次带电机 | 台式电源端约 8.5–9 V，先量二极管后的实际母线。相电流目标峰值先试 0.10–0.15 A，短时验证 | 属于调试起点，电机不转时先检查相序、电角度和采样，再考虑逐级调整 |
| 底板设计目标 | 12 V 标称，初版台架输入设在约 8.5–12 V。功率铜皮与器件按 2 A RMS 相电流预留设计余量。首版约 ±1.5 A 峰值硬件门限优先生效，不能用于 2 A RMS 运行 | 电路容量与电机允许电流分别管理。软件初始相峰值上限可设 0.3 A，待确认温升和额定电流再上调 |
| PWM / 电流环 | 20 kHz 中心对齐，初期每个完整 PWM 周期执行一次电流环 | 以示波器验证真实触发次数、死区和采样窗口 |

[淘宝商品短链](https://e.tb.cn/h.jTJdEW7QljhsQ3P?tk=Okpb6b6j738) · [同类 2804 的多个规格示例](https://www.dfrobot.com.cn/goods-4230.html) · [正点原子阿波罗 V2 官方资料帖](https://www.openedv.com/thread-344988-1-1.html)

## 2. 编码器选型

### 2.1 AS5600 能做到什么

AS5600 为 12 位单圈绝对磁编码器。每个码约 0.088° 机械角，7 极对下约 0.615° 电角。实际角度误差还受磁铁安装、外转子漏磁和滤波延迟影响。按匀速近似，角度延迟的量级为：

```text
电角速度（°/s） = 6 × rpm × 极对数
电角滞后（°）   ≈ 6 × rpm × 极对数 × 总延迟（s）
```

| 机械转速 | 电频率 | 假设延迟 0.286 ms | 假设延迟 0.5 ms | 假设延迟 2.2 ms |
|---:|---:|---:|---:|---:|
| 100 rpm | 11.7 Hz | 1.2° | 2.1° | 9.2° |
| 300 rpm | 35.0 Hz | 3.6° | 6.3° | 27.7° |
| 600 rpm | 70.0 Hz | 7.2° | 12.6° | 55.4° |
| 1400 rpm | 163.3 Hz | 16.8° | 29.4° | 129.4° |

0.286 ms 和 2.2 ms 对应手册里慢滤波不同配置的阶跃响应时间，用于估算量级。实际匀速等效延迟应在所用滤波配置下测量，并计入 I²C 读数、固件排队及控制执行。若把总滞后预算设为 10° 电角，1400 rpm 时只有约 170 µs。先在 100–300 rpm 观察电流与速度，再依据实测扩大范围。低速可用机械速度对带时间戳的角度做短时外推，但加减速或数据过期时要限制外推。 [AS5600 数据手册](https://look.ams-osram.com/m/7059eac7531a86fd/original/AS5600-DS000365.pdf) · [AS5600 评估板手册](https://look.ams-osram.com/m/4f8342513a447495/original/AS5600_UG000254_2-00.pdf)

### 2.2 AS5600 接法与调试

1. 核对套件针序、是否引出 SDA/SCL、板载上拉接到了哪条电源。确认支持后用 3.3 V 供电。若模块必须用 5 V，先核对板载上拉和 MCU 引脚电平，必要时用双向电平转换。
2. I²C 设 400 kHz。上拉默认预留 2.2 kΩ 和 4.7 kΩ 的选值位置，结合模块已有上拉和实测上升时间确定。接插件附近放 100 nF + 1 µF，线束短并远离 U/V/W。
3. 器件 7 位地址为 `0x36`。从 `RAW ANGLE` 高字节寄存器 `0x0C` 连读两字节，取低 12 位。常见带寄存器寻址的两字节读约 45 个 SCL 周期，400 kHz 下约 113 µs，另计软件开销。角度任务可从 1 kHz 起步，验证后试 2 kHz。采用非阻塞读取和时间戳，电流中断使用最近一次有效结果。
4. 初期使用正常功耗模式，将慢滤波 `SF` 设为 `11`（2×），先关闭快滤波阈值以便对照，再结合噪声和延迟决定是否启用。配置写入 RAM，调试时避免烧录 OTP。
5. 手转一圈检查读数单调、回绕连续、方向正确，检查 `STATUS` 中 `MD/ML/MH` 及 `AGC`。检查磁铁与芯片同轴、固定牢靠。出现 NACK、磁铁异常或样本超时，停止施加转矩并记录故障。超时门限按实际更新周期和转速设定。

### 2.3 何时升级 SPI

| 目标 | 建议 |
|---|---|
| 六步扇区换向、低速电流环和位置保持 | 用已有 AS5600 |
| 约 1400 rpm 带载，关心 Id/Iq 跟踪、转矩脉动或快速反转 | 优先 AS5047P，先测 AS5600 与预期的差距 |
| 低速角度仍周期性摆动 | 先检查磁铁偏心、气隙与漏磁，用手转数据区分机械安装和采样延迟 |

AS5047P 有 14 位 SPI 角度和动态角误差补偿，可减少较高转速下角度反馈延迟的影响。SPI 按器件手册处理 16 位帧、读响应流水线、奇偶校验与错误位。低速起调可用 1–2 MHz，并测量角度采样到 PWM 生效的总延迟。优先选有机械图和引脚图的模块，核对同轴、磁铁磁化方向、有效气隙与安装孔。底板留 `3V3/GND/SCK/MOSI/MISO/CS` 及可选第二地针，SCK 源端预留 22–47 Ω。编码器可独占一组 SPI，角度读取按时间戳进入电流环。 [AS5047P 厂商产品页](https://www.infineon.com/part/AS5047P) · [磁角度器件对照](https://look.ams-osram.com/m/8afbfbd9bb094a0f/original/Position_Sensors_FS001005_2-00.pdf)

## 3. 电源树与输入保护

```text
台式电源 +VIN → XT30PW-M
  └─ F1 ─ D1 串联防反接 ─ VM_BUS
       ├─ TVS + 470 µF 母线电容 + 就地 MLCC
       ├─ 三相逆变桥 → U / V / W → 2804
       ├─ VBUS_ADC + 独立过压比较器
       ├─ 可选制动电阻 / MOSFET 焊位
       └─ LMR51420 → 5V_BUCK
            ├─ JP_CORE_5V → 核心板 5 V 输入 → 板上稳压器
            ├─ TLV75533P → 3V3_DRV → INA181、参考缓冲、比较器、逻辑门与编码器
            └─ TPS61040 → 10V_GATE → DRV8300 GVDD → 三相自举
电源负端 ── GND ── 功率回流、底板信号地和核心板地
```

### 3.1 输入、母线与回灌

| 位置 | 首版器件或参数 | 原理图与验证 |
|---|---|---|
| 电源端子 | AMASS XT30PW-M，C431092，板载通孔公头 | 按该料号图纸确定孔距、正负极、卧式出线和板边插拔空间。电源线用配对母头，给接插件机械支撑 |
| F1 | 2 A 慢断保险丝及座，核对 DC 额定值 | 初选用于 12 V 台架，按启动浪涌和实测输入电流选值。保险丝负责输入级保护，电机限流在相电流侧实现 |
| D1 | STPS5L60S，60 V / 5 A | 正向串入，阴极朝 VM_BUS。按约 0.4–0.55 V 压降，2 A 时热耗约 0.8–1.1 W，给封装留散热铜。电机电压按二极管后实测 |
| TVS | SMBJ18A 单向，阴极接 VM_BUS | 反向工作电压 18 V，规定浪涌条件下钳位 29.2 V。用于短脉冲。测量 Buck VIN 和各管 VDS 的实板尖峰 |
| 母线电容 | 470 µF / 50 V 低 ESR，预留第二颗 | 比较电解纹波额定与实测。桥旁另放 2×4.7 µF / 50 V X7R 与 100 nF / 50 V，关注直流偏压下有效容量 |
| 放电 | 4.7 kΩ / 0.25 W 跨 VM_BUS | 与 470 µF 的时间常数约 2.2 s。断电后用表确认母线下降再换线 |
| VBUS_ADC | 100 kΩ / 10 kΩ，0.1%，ADC 节点就近 4.7 nF | 12 V 时约 1.09 V，29.2 V 时约 2.65 V。慢速 ADC 选足够采样时间，测量并校准 ADC 基准。预留串阻及钳位位置，校核掉电注入电流 |
| 过压 | 独立比较器，约 14.35 V 触发 Break | 比较器采独立 `127 kΩ / 10 kΩ` 分压与约 1.048 V 阈值。软件可先用约 13.5 V 阈值退出驱动。两个阈值适用于本报告的 12 V 台架设定 |

D1 会阻止母线把再生电流送回台式电源。减速、被外力拖动、转子仍转动时断开驱动，都可能使母线升高。关 PWM 后桥臂体二极管仍可能整流，所以过压 Break 只能撤销驱动命令。470 µF 从 12 V 上升到 14.35 V 只储存约 0.0146 J 额外能量。首版不装制动支路时，用低速、低惯量、自由滑停做实验，测减速时母线峰值后再提高转速。

若要快速减速或反转，把制动电阻支路设计为 `VM_BUS → 制动电阻 → N-MOS → GND`，用带迟滞的独立比较器控制，并配合具有明确输出电平的栅极驱动。例值是 14.5 V 接通、13.5 V 关闭，电阻 15 Ω，14.5 V 时瞬时约 14 W。可从 25 W 底盘安装电阻做样机预算，按实际散热条件、脉冲能量、最大转动惯量及重复频率重算。制动动作点和硬件 Break 点需协调。若采用这组 14.5 V 制动点，硬件过压阈值可重新设计到约 15.2–15.5 V，同时保留软件先限再生转矩的策略，并计入公差。制动比较器和功率开关可预留，首版默认未装。 [ST 防反接二极管数据手册](https://www.st.com/resource/en/datasheet/stps5l60.pdf) · [Littelfuse SMBJ 数据手册](https://www.littelfuse.com/assetdocs/tvs-diodes-smbj-series-datasheet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) · [TI 电机驱动母线供电与回灌参考](https://www.ti.com/lit/ds/symlink/drv8323.pdf)

### 3.2 5 V Buck 与 3.3 V

| 器件 | 首版参数 | 连接与选值 |
|---|---|---|
| U1 | LMR51420XDDCR，500 kHz 同步 Buck，额定 2 A | VIN 接保护后的母线。按 TI 5 V 参考电路连接。EN 默认随母线上电，若设置独立 UVLO，按 EN 门限容差与负载重新计算 |
| L1 | 10 µH 屏蔽型，例如 Coilcraft XAL5050-103MEC | 按最小电感、温度、过流状态的峰值和饱和曲线复核。12 V 输入、5 V 输出时名义纹波约 0.58 A 峰峰值 |
| Buck 输入 | 2.2 µF / 50 V + 100 nF，另留 4.7–10 µF / 50 V 焊位 | 电容靠 VIN/GND，直流偏压后的容量和热插拔峰值实测 |
| Buck 输出 | 2×22 µF / 16 V X7R | 遵循参考设计，检查有效电容和负载阶跃 |
| Buck 反馈与自举 | 上 100 kΩ、下 13.7 kΩ，均 1% 或更好。CB–SW 间 100 nF / 25 V | 标称约 4.98 V。FB 从输出电容取样，远离 SW |
| U2 | TLV75533PDBVR，固定 3.3 V | 输入 1 µF，输出 2.2 µF X7R，核对有效电容。底板 3.3 V 预算先按 100 mA，LDO 约耗 0.17 W |
| 核心板 5 V | 5V_BUCK 经可断开的 0 Ω 或跳线 | 先按核心板支路预留 0.5 A 预算，再实测。USB 调试与底板供电需核对回灌路径。优先 SWD，目标电压参考脚用来检测核心板电平 |
| 分电源调试 | 5V_BUCK、CORE_5V、3V3_DRV 与核心板 3.3 V 各留测试点 | 如需核心板单独 USB 供电，先断开 5 V 跳线，并核对 PWM、I²C 上拉、SPI、ADC 信号的掉电注入路径。首版常用接法为统一由底板上电 |

[TI LMR51420 数据手册，表 9-1 与布局示例](https://www.ti.com/lit/ds/symlink/lmr51420.pdf) · [Coilcraft 电感系列](https://www.coilcraft.com/en-us/products/power/high-voltage-inductors/xal/xal50xx/) · [TI TLV755P 数据手册](https://www.ti.com/lit/ds/symlink/tlv755p.pdf)

### 3.3 栅极供电和电流中点

DRV8300DPWR 使用独立的 `10V_GATE`。采用 **TPS61040DBVR，SOT-23-5**，从稳定的 5V_BUCK 升到约 10 V。这样在低压启动和母线回灌时仍有确定的栅极供电。按所选手册的完整 Boost 应用电路连接，首版参数如下。

| 项目 | 起始值与核对 |
|---|---|
| 电感 / 整流 | 10 µH，直接复用 XAL5050-103MEC。输出整流用 MDD SS14，SMA，40 V / 1 A。两者引脚均可从外侧焊接 |
| 反馈 | 上 715 kΩ、下 100 kΩ，均 1%。按 1.233 V 基准估算约 10.05 V。上臂并联前馈电容先用 10 pF，再按轻载纹波与启动波形微调 |
| 输入 / 输出 | 输入 4.7–10 µF / 10 V + 100 nF。输出 22 µF / 25 V X7R，校核有效电容，并在 DRV GVDD 附近放 2.2 µF / 25 V + 100 nF |
| 负载 | 以 AO4266 的 30 nC 栅电荷上界、6 管、20 kHz 全开关估算，平均栅极充电电流约 3.6 mA。叠加驱动静态与自举损耗，10 V 支路先按 20 mA 连续负载预算，实测启动和预充时的瞬态 |
| 自举 | DRV8300DPWR 集成自举二极管。每相 BSTx–SHx 先用 220 nF / 25 V X7R，检查最小有效电容和最大高侧导通时间，DRV 近端储能按手册要求至少覆盖自举电容的供能需求 |
| 上电许可 | 第 8 路 TLV1704 检查 10V_GATE，欠压时拉低 FAULT_OK。可用 76.8 kΩ / 10 kΩ 分压与约 1.048 V 比较，名义释放点约 9.1 V。正端接分压、负端接参考，增加小迟滞并实测抖动 |
| 1.65 V 中点 | 3V3_DRV 经两颗 10 kΩ / 0.1% 分压，中点 1 µF 到地，送 TLV9001IDBVR 电压跟随器。跟随器输出供三颗 INA181 的 REF。按运放稳定性要求布置电容，需要输出去耦时预留隔离电阻并检查输出稳定性 |

TPS61040 的 400 mA 是内部开关电流规格，输出按 10 V / 20 mA 校核。芯片 EN 随稳定 5 V 电源使能，PWM 总许可 MCU_ARM 保持低，待全部电源和采样稳定再启动。 [TPS61040 数据手册](https://www.ti.com/lit/ds/symlink/tps61040.pdf) · [DRV8300 自举设计](https://www.ti.com/lit/ds/symlink/drv8300.pdf) · [TLV9001 数据手册](https://www.ti.com/lit/ds/symlink/tlv9001.pdf)

## 4. 三相桥、采样和故障关断

### 4.1 栅极驱动器和 MOSFET

本版按电烙铁手焊选用外露引脚。驱动器为 **DRV8300DPWR**，MOS 为 **AO4266**，电流采样由三颗独立 INA181A1 实现。BOM 使用对应的制造商型号和立创编号，封装图以厂商当前手册为准。

| 项目 | 选型及落图 |
|---|---|
| 栅极驱动器 | TI **DRV8300DPWR**，TSSOP-20，0.65 mm 脚距，普通外露引脚封装。D 表示内置自举二极管，本订货型号的 INL 为同相输入。六路 3.3 V PWM 经外部许可逻辑送入，满足逻辑高门限 |
| MOSFET | AOS **AO4266** ×6，SO-8，1.27 mm 脚距，60 V。按原厂手册，25°C 时 RDS(on) 最大 15 mΩ @ 10 V、19 mΩ @ 4.5 V，总栅电荷最大 30 nC @ 10 V。商城摘要的阻值可能对应其他测试条件，计算使用原厂手册 |
| 每相功率连接 | 上管 D 接 VM_BUS，S 接 U/V/W。下管 D 接相节点，S 经独立 20 mΩ 分流到功率地。GHx 接上管 G，SHx 接相节点，GLx 接下管 G，驱动 GND 连接低阻抗功率参考地。按所选封装逐个核对 G/D/S |
| 栅极网络 | 每管串 10 Ω 起调，预留 4.7–22 Ω 选值，G–S 47 kΩ 就近。用 VGS 波形核对上下管死区、振铃与关断 |
| 去耦 | GVDD 接 10V_GATE，近端 2.2 µF + 100 nF。每相 BSTx–SHx 220 nF 起调。电容靠对应管脚，供电与回流短 |
| 数字许可 | **SN74LVC08ADR ×2**，SOIC-14，3.3 V 供电。1 个与门产生 `GATE_EN = MCU_ARM AND FAULT_OK`，6 个与门产生 `DRV_INx = TIM1_PWMx AND GATE_EN`，剩余门输入固定电平。MCU_ARM 10 kΩ 下拉，6 路 DRV_IN 各 47 kΩ 下拉，输出串 22–47 Ω |
| 死区 | TIM1 初设约 500 ns，DRV8300 TSSOP 版本有典型 200 ns 内部死区。实际死区以 VGS 测量为准。TIM1 的互补逻辑和输出极性必须使关断状态为六路低 |
| 功耗 | 按 2 A RMS 相电流、15–19 mΩ 估算三相总 MOS 导通损耗约 0.18–0.23 W，热态与开关损耗另计。该电流仅用于器件和布线裕量校核，实际约 ±1.5 A 相峰值窗口优先关断 |

**自举时序要一起实现。** 在确认电机静止、三相电流为零并完成 ADC 零点采集后，开启总许可，三路上管关断，三路下管短时导通约 0.5–1 ms 做自举预充，测 10V_GATE 和三路 BST–SH 是否稳定。六步采用高侧 PWM，FOC 初期占空比上限设在约 90%，保留每周期下管刷新时间，再按实际自举电压和 ADC 窗口调整。悬空相重入高侧前，检查自举电容在最长悬空时间后的压降，必要时加入受控预充并用示波器验证。 [TI DRV8300 数据手册](https://www.ti.com/lit/ds/symlink/drv8300.pdf) · [AOS AO4266 数据手册](https://www.aosmd.com/res/datasheets/AO4266.pdf) · [TI SN74LVC08A](https://www.ti.com/lit/ds/symlink/sn74lvc08a.pdf)

### 4.2 三路外置电流采样

- 分流用 **大毅 RLM25FECR020** ×3，2512，20 mΩ / 1% / 1 W。以每颗承受完整相 RMS 为上界，2 A 时每颗约 80 mW。从电阻内侧两端独立 Kelvin 走线到放大器。
- 放大器用 **TI INA181A1IDBVR** ×3，SOT-23-6，0.95 mm 脚距，固定增益 20 V/V，3.3 V 供电，每颗去耦 100 nF。IN+ 接下管源极侧，IN− 接分流地侧，REF 接缓冲后的 1.65 V 中点。
- 电流方向以分流从源极流向地为正，`VOUT ≈ VREF + 0.40 × Ishunt`，`Ishunt = (VOUT − Vzero) / 0.40`。三路符号用已知小电流核对。±1 A 输出约 1.25–2.05 V，±1.5 A 输出约 1.05–2.25 V。12 位 ADC、3.3 V 基准时理想分辨率约 2.0 mA/LSB。
- 按输出 0.25–3.05 V 留设计裕量，标称数学量程约 ±3.5 A。实际范围按 INA181 在 3.3 V 供电、ADC 负载和温度下的输出摆幅校核。IN± 电压含开关尖峰必须满足器件规格，Kelvin 线短且成对，输入滤波两侧匹配。
- 每路 OUT 经 100 Ω、ADC 侧 470 pF 起调。INA181A1 的带宽为 350 kHz，ADC 起始采样点可放在有效低侧窗口内、开关边沿后至少约 4–5 µs，再按输出建立波形、采样孔径和纹波实测收敛。高占空比需要为两路有效采样保留窗口。
- 上电时保持桥关断、确认无绕组电流后采集零点。两路有效时按 `Ic = −Ia − Ib` 重构第三路。每次更换采样电阻、放大器或 ADC 基准，都重新校准零点与增益。 [INA181 数据手册](https://www.ti.com/lit/ds/symlink/ina181.pdf) · [大毅分流电阻参数](https://item.szlcsc.com/983045.html)

### 4.3 外部硬件保护

| 层级 | 本版设计 |
|---|---|
| 电机工作电流 | 固件限 Iq、监控相峰值和温升。首次相峰值软件上限仍为 0.3 A，待电机额定电流和实测数据收敛 |
| 三相窗口过流 | TLV1704AIPWR ×2 中用 6 路比较器，分别检查各 INA181 OUT。下限约 1.048 V，上限约 2.252 V，名义门限约 ±1.5 A。下限比较器正端接 OUT、负端接下阈值，上限正端接上阈值、负端接 OUT。参考分压用 21.5 kΩ / 10 kΩ 与互换组合 |
| 母线过压 | 第 7 路比较器，正端接约 1.048 V 参考、负端接 127 kΩ / 10 kΩ 母线分压，约 14.35 V 拉低故障输出。制动支路装配时按第 3 节协调门限 |
| 栅极电源欠压 | 第 8 路检查约 10 V 栅极电源，低于约 9.1 V 拉低故障输出。加入迟滞，测量上电、预充与急停过程 |
| 硬件撤销 PWM | 八路开集输出汇接 FAULT_OK，4.7 kΩ 上拉到 3V3_DRV，同时连接 TIM1_BKIN 与外部与门。任一路故障使六路 DRV 输入立即为低。TIM1 Break 关闭 MOE，AOE=0，故障解除后等待明确重新启动 |
| 关断与测温 | 驱动的交叉导通抑制、自举欠压及 GVDD 欠压保护配合外部采样关断。PCB 保留 MOS 附近 NTC，并给 FAULT_OK、GATE_EN、MCU_ARM 与三路 OUT 留测试点 |
| 启动 | MCU_ARM 默认低，先确认 5 V、3.3 V、10 V、中点、三路 ADC 零点及编码器。清除启动过程的 Break 标志，再显式 ARM，执行静止预充，最后施加小电流指令 |

比较器输入可从各 OUT 引出独立 1 kΩ / 470 pF 支路作为起调值。用已知电压注入实测门限，再测从电流输出越限到六路 DRV 输入关断的时间。低侧采样的有效观测窗口、INA181 的建立与过载恢复、比较器及滤波延时一起计入响应预算。保持电源限流和输入保险丝，初期在小电流条件下验证。所有故障默认锁存停机，由程序记录触发源、母线与相电流后显式重启。 [TLV1704 数据手册](https://www.ti.com/lit/ds/symlink/tlv1704.pdf) · [DRV8300 保护与输入真值表](https://www.ti.com/lit/ds/symlink/drv8300.pdf)

## 5. 阿波罗 H7 V2.5 底板接口

以 STM32H743 系列为规划对象，连接器必须用手上核心板对应版的图纸或实测定义。官方发布的资料是阿波罗 V2 系列，现有信息不足以核对 V2.5 核心板的每个连接器脚位。下表列 MCU 资源和核对方法，连接器针号在定版时填写。

| 网络 | MCU 资源 | 约束 |
|---|---|---|
| PWM_UH/UL、VH/VL、WH/WL | TIM1_CH1/1N、CH2/2N、CH3/3N，必要时整组改 TIM8 | 初查 PA8/PA9/PA10 作主输出、PB13/PB14/PB15 作互补输出。核对核心板占用、SWD、USB 与 SPI 冲突。PE8–PE15 虽有 TIM1 功能，同组多脚也可复用 FMC，需先排查板载存储 |
| FAULT_OK | TIM1_BKIN 或所选定时器的 Break | PA6 或 PE15 可列为 TIM1 候选，再查对应板版原理图。低有效，关闭自动恢复 |
| IU / IV / IW | 可用 ADC1/ADC2 注入通道 | 优先两路在 ADC1/2 同步读取，第三路按实测窗口诊断或按板上 ADC 资源实现。检查输入引出、采样时间及 ADC 触发矩阵 |
| VBUS、NTC、可选 BEMF | 剩余 ADC 通道 | 母线和温度用慢速组。BEMF 需要 PWM 同步及可控采样点 |
| MCU_ARM / FAULT_OK | GPIO + TIM1_BKIN | MCU_ARM 默认下拉，FAULT_OK 同时进入与门和 Break。DRV8300 通过六路 PWM 控制 |
| AS5600 | 一组 I²C | 上拉到 3.3 V，与磁编码器排针连接 |
| AS5047P 预留 | 第二组 SPI + CS | 6 针或带额外地针的 7 针接口。SPI 和 I²C 可共用限流后的编码器电源 |
| 调试 | SWDIO、SWCLK、NRST、VTref、GND，另预留 UART | VTref 依调试器接法取核心板参考电平。UART 用 3.3 V 逻辑 |
| 供电 | CORE_5V 与足够的 GND 针脚 | 按官方设计使用指定供电脚和接地脚，避免桥臂大电流流经核心板接插件 |

**落板前的顺序**

1. 拆下核心板，拍清两面丝印和连接器 Pin 1，确认 V2.5 标在核心板还是原底板，并核对 MCU 型号。
2. 取得对应版本原理图。为每个信号填写 `MCU 管脚 → 核心板网名 → 连接器座和针号 → 自制底板网名`，同时标注板载 SDRAM、NAND、QSPI、USB、LCD 等占用。CubeMX 用实际 MCU 封装检查 AF 和 ADC 触发，纸面网表再查一遍。
3. 连接器购买前实测配对公母、排距、间距和堆叠高度，注意 PCB 顶视图与连接器对插视图的镜像。用 1:1 封装打印件对合核心板，确认螺柱、USB、SWD、散热和取拔空间。
4. 底板空载先验证接插件 5 V、GND、电源切换和 PWM 输入默认状态，再插核心板。原扩展板可先用于 AS5600、串口、定时器和 ADC 基础验证。 [正点原子阿波罗 V2 官方资料帖](https://www.openedv.com/thread-344988-1-1.html) · [STM32H743 数据手册和 AF 表](https://www.st.com/resource/en/datasheet/stm32h743ii.pdf) · [STM32H7 RM0433](https://www.st.com/resource/en/reference_manual/rm0433-stm32h742-stm32h743-753-and-stm32h750-value-line-advanced-armbased-32bit-mcus-stmicroelectronics.pdf)

## 6. PCB 和 BOM 检查

### 6.1 原理图分块

1. `Input_Protection`：端子、保险、防反接、TVS、母线储能、放电和制动预留。
2. `Power_5V_3V3`：Buck、LDO、核心板 5 V 隔离跳线、测试点。
3. `Gate_Driver`：DRV8300DPWR、TPS61040 栅极供电、自举电容、六路 PWM 许可与故障。
4. `Three_Phase_Bridge`：6 MOS、3 分流、相线端子、可选相节点 RC 吸收焊位。
5. `Sense_Protection`：三颗 INA181、参考缓冲、电流 ADC RC、硬件过流及过压、温度和 BEMF 预留。
6. `H7_Core_Encoder`：核心板座、I²C / SPI、SWD、UART。

### 6.2 布局顺序

- 采用 6 层，具体层分配和铜厚见 6.2.2。布线前确定母线电容、桥臂、分流、驱动和电机端子的相对位置。
- 紧凑布置“高频母线电容正端 → 上下桥臂 → 分流 → 电容负端”环路。U/V/W 相节点、Buck SW 铜面积保持满足载流所需的大小，远离反馈、电流采样和编码器。
- 驱动器的 GH/GL 走线与相应回流靠近，栅极电阻贴近栅极。Kelvin 取样差分对短且成对，和功率回流分开走。驱动器各地与裸焊盘按 TI 指引汇接到低阻抗平面。
- 母线回流优先回母线电容地。避免让大电流穿过 ADC、参考和编码器地附近。对高速信号保留连续回流平面，避免跨地缝。
- 预留 VM、5V、3V3、三相节点、GH/GL、INA OUT、FAULT_OK、GATE_EN、MCU_ARM 和就近地测试点。高侧 VGS 用差分探头或合适的隔离测法，普通接地探头的地夹接板 GND。  
- 温度预留 10 kΩ NTC（例如 B=3950）靠近 MOS 或输入二极管，配 10 kΩ 分压和慢速 ADC 滤波。空载首试前固定电机并防止接触外转子。 [TI DRV8300 布局指南](https://www.ti.com/lit/ds/symlink/drv8300.pdf)

### 6.2.1 电流与损耗核算

**现有选型足够做空载和轻载学习。首版约 ±1.5 A 的硬件相峰值门限优先于 2 A RMS 铜皮设计目标。** 正弦线电流按 1.5 / √2 ≈ 1.06 A RMS 换算，这是名义触发点对应值。给 PWM 电流纹波、放大器增益和零点误差及比较器公差留余量后，连续指令应更低。电机额定相电流确认前，沿用初始 0.3 A 相峰值软件上限。六步换向的波形按实际导通周期计算 RMS。

若 0.03 N·m 与 1400 rpm 对应同一个工况，机械输出为 `0.03 × 2π × 1400 / 60 ≈ 4.40 W`。假设 12 V 台式电源经 D1 后母线为 11.5 V，Buck 支路按核心板 0.5 A、模拟与逻辑 0.1 A、Boost 5 V 输入约 0.05 A，合计 5 V × 0.65 A、效率 85% 预算，则控制支路约占 0.33 A 输入电流。用不同的电机与逆变桥合计效率估算：

| 电机与桥合计效率，假设 | 电机与桥的母线平均电流 | 含控制支路的台式电源平均电流 |
|---|---:|---:|
| 80% | 0.48 A | 0.81 A |
| 60% | 0.64 A | 0.97 A |
| 40% | 0.96 A | 1.29 A |

若现有台式电源可在 12 V 稳定输出 2 A，则上述工况估算有余量。首轮仍应按静态电流加小幅增量设置限流。母线平均电流、相峰值和相 RMS 应分别记录。低占空比和低速时，相电流可比母线平均电流高，2 A 输入保险管也无法保护电机绕组免受长时间过流。0.03 N·m 的工况、额定相电流、转矩常数和实际效率仍待确认，因此此计算不能验证该电机在 1400 rpm 能持续输出 0.03 N·m。还要测 D1 后的电压与调制裕量，12 V 电源设定不等于 12 V 母线。

| 路径 | 按 2 A 做器件或布线裕量核算 |
|---|---|
| MOSFET | 按三相正弦、每相主要经一只 MOS 导通，用 `3 × Iphase,rms² × RDS(on)`。AO4266 的 25°C 最大值为 15 mΩ @ 10 V 或 19 mΩ @ 4.5 V，估算三相总导通损耗约 0.18–0.23 W。开关、死区体二极管与热态损耗另计，低母线起调时实测 VGS |
| 20 mΩ 分流 | 按每颗承受完整相电流 RMS 的上界，`2² × 0.020 = 0.080 W`。1 W 规格有充足余量，Kelvin 焊盘及零点、增益标定决定采样品质 |
| 输入防反接二极管 | 2 A 输入、约 0.4–0.55 V 压降时，约 0.8–1.1 W，是优先检查的发热点。按 ST 焊盘和散热要求留铜，实测输入电流与壳温 |
| Buck | 2 A 是 5 V 支路额定输出规格。电机母线直接供三相桥，电机电流不经过 Buck。核心板支路按实测 5 V 电流核对 |

首版若出现限流，先看三路 INA OUT 波形、FAULT_OK、GATE_EN 与 BKIN 标志，区分真实过流和 PWM 边沿毛刺。2 A RMS 正弦相电流需要约 2.83 A 峰值，再加纹波余量，当前窗口会先关断。确需运行到该点时，先拿到电机持续/峰值电流数据，再按 INA181 量程、比较器门限和温升重新设计保护并复验。 [AOS AO4266](https://www.aosmd.com/res/datasheets/AO4266.pdf) · [TI DRV8300](https://www.ti.com/lit/ds/symlink/drv8300.pdf) · [ST STPS5L60](https://www.st.com/resource/en/datasheet/stps5l60.pdf)

### 6.2.2 六层板铜厚与布线起点

首版可选 **外层 1 oz，内层 0.5 oz**，高频功率回路留在 L1。1.6 mm 板厚可作常规机械起点，以下单叠层和核心板连接器配合高度为准。

| 层 | 分配 |
|---|---|
| L1 | MOS、驱动、分流、就地母线电容、Buck 和电机端子。三相功率回路及栅极回路尽量同层闭合 |
| L2 | 连续 GND，作为顶层信号和采样回流参考 |
| L3 | 电流采样、参考、编码器及控制信号，优先参考 L2 |
| L4 | 5 V、3.3 V、需要分配的 VM_BUS 静态电源铜区 |
| L5 | 连续 GND，作为 L6 参考 |
| L6 | 低速信号、调试和可用接地铜皮，避开相节点投影区内的敏感走线 |

L1 的 U/V/W 长段以 **1.5 mm** 或等效短铜皮起画。输入正极到桥、分流低端到母线电容负端优先用 **2 mm 以上等效铜宽**。这些是布局起点，MOS 焊盘、端子、热焊盘和铜皮收窄处逐段检查。确需换层时，2 A 支路可先预留 **3–4 个约 0.30 mm 成品孔的并联过孔**，再按板厂孔铜、回流路径与空间定版。避免把相节点或 Buck SW 扩成跨层大面积铜。

以 20°C 铜电阻率约 0.0172 Ω·mm²/m、外层 1 oz 约 0.035 mm、30 mm 单程为例：

| 铜宽 | 电阻 | 2 A 时压降 | 2 A 时铜损 |
|---:|---:|---:|---:|
| 1.0 mm | 14.7 mΩ | 29.5 mV | 59 mW |
| 1.5 mm | 9.8 mΩ | 19.7 mV | 39 mW |
| 2.0 mm | 7.4 mΩ | 14.7 mV | 29 mW |

同长同宽的 0.5 oz 铜损约为两倍。该估算用于比较布线，实板温升还取决于相邻铜层、过孔、铜皮颈缩和环境。首板记录稳定工况下的 D1、MOS、分流和过孔附近温升。布局阶段先压缩母线高频回路，保留分流电阻两端独立 Kelvin 线，防止相节点与 Buck SW 的边沿耦合进 ADC 和编码器。 [嘉立创六层板工艺](https://jlcpcb.com/resources/6-layer-pcbs) · [TI DRV8300 布局指南](https://www.ti.com/lit/ds/symlink/drv8300.pdf) · [IPC-2152 载流量与温升资料](https://www.ipc.org/system/files/technical_resource/E7%26S22_03.pdf)

### 6.3 手焊版采购 BOM 与成本

本表为当前主选，2026-11-05 更新。新选器件已核对制造商和封装。单价记录立创公开页面可见的小批量美元报价，部分沿用 11-04 的报价快照。库存、起订量和国内人民币实付按购物车核价，起价与小批量价分别标注。

| 用途 | 制造商与型号 | 封装 / 手焊要点 | 单板数量 | 立创编号 | 公开样品单价 / 采购说明 |
|---|---|---|---:|---|---|
| 三相驱动 | TI DRV8300DPWR | TSSOP-20，0.65 mm 外露脚 | 1 | [C3036056](https://www.lcsc.com/product-detail/C3036056.html) | $0.6765，1 颗档 |
| 功率 MOS | AOS AO4266 | SO-8，1.27 mm 外露脚 | 6 | [C125865](https://item.szlcsc.com/137145.html) | $0.5443/颗，6 颗约 $3.27 |
| 电流放大器 | TI INA181A1IDBVR | SOT-23-6，0.95 mm 外露脚 | 3 | [C2058943](https://www.lcsc.com/product-detail/C2058943.html) | $0.4216/颗，1 颗档，3 颗约 $1.26 |
| 电流中点缓冲 | TI TLV9001IDBVR | SOT-23-5，外露脚 | 1 | [C398363](https://www.lcsc.com/product-detail/C398363.html) | $0.0988/颗，5 颗档约 $0.49 |
| PWM 许可逻辑 | TI SN74LVC08ADR | SOIC-14，1.27 mm 外露脚 | 2 | [C468253](https://www.lcsc.com/product-detail/C468253.html) | $0.1665/颗，5 颗档约 $0.83 |
| 三相分流 | 大毅 RLM25FECR020 | 2512，20 mΩ / 1% / 1 W | 3 | [C913034](https://item.szlcsc.com/983045.html) | 国内站核价，三相同料号 |
| 5 V Buck | TI LMR51420XDDCR | SOT-23-THIN-6，外露脚 | 1 | [C5246146](https://item.szlcsc.com/5955992.html) | $0.8258，1 颗档 |
| 10 V 栅极 Boost | TI TPS61040DBVR | SOT-23-5，外露脚 | 1 | [C7722](https://www.lcsc.com/product-detail/C7722.html) | $0.7418，1 颗档 |
| 电感 | Coilcraft XAL5050-103MEC | 10 µH，核对推荐焊盘并保留烙铁接近空间 | 2 | [C5441578](https://www.lcsc.com/product-detail/C5441578.html) | Buck 与 Boost 各 1，$1.7458/颗，约 $3.49 |
| Boost 整流 | MDD SS14 | SMA，两端可焊，40 V / 1 A | 1 | [C2480](https://item.szlcsc.com/2857.html) | 国内站核价 |
| 3.3 V LDO | TI TLV75533PDBVR | SOT-23-5，外露脚 | 1 | [C404027](https://item.szlcsc.com/391018.html) | $0.1436/颗，5 颗档约 $0.72 |
| 窗口与电压比较器 | TI TLV1704AIPWR | TSSOP-14，0.65 mm 外露脚 | 2 | [C181596](https://www.lcsc.com/product-detail/C181596.html) | $1.6017/颗，约 $3.20 |
| 输入防反接 | ST STPS5L60S | SMC，两端可焊，60 V / 5 A | 1 | [C140620](https://item.szlcsc.com/151946.html) | $0.5519，1 颗档 |
| 母线 TVS | Littelfuse SMBJ18A | SMB，两端可焊 | 1 | [C151256](https://www.lcsc.com/product-detail/C151256.html) | $0.1492/颗，5 颗档约 $0.75 |
| 母线储能 | Panasonic EEUFM1H471 | 直插，470 µF / 50 V | 1 | [C178692](https://item.szlcsc.com/190085.html) | $0.6556，1 颗档 |
| 母线 MLCC | Murata GRM31CR71H475KA12L | 1206，4.7 µF / 50 V，X7R | 2 | [C77096](https://www.lcsc.com/product-detail/C77096.html) | 国内站核价 |
| Buck 输出 | Murata GRM32ER71C226MEA8L | 1210，22 µF / 16 V，X7R | 2 | [C415372](https://www.lcsc.com/product-detail/C415372.html) | 国内站核价 |
| 通用去耦 | YAGEO CC0603KRX7R9BB104 | 0603，100 nF / 50 V，X7R | 按位号 | [C14663](https://www.lcsc.com/product-detail/C14663.html) | 数量由原理图导出 |
| 保险管 | Littelfuse 0218002.MXP | 5×20 mm，2 A 慢断 | 1 | [C142702](https://www.lcsc.com/product-detail/C142702.html) | 核对直流条件，国内站核价 |
| 保险座 | 旭程 XC-7 | 5×20 mm，PCB 直插 | 1 | [C3131](https://item.szlcsc.com/3520.html) | 国内站核价 |
| 电源输入 | AMASS XT30PW-M30.G.Y，商品简称 XT30PW-M | **通孔焊接，卧式插接方向，公头** | 1 | [C431092](https://www.lcsc.com/product-detail/C431092.html) | $0.3761，1 颗档。按该确切型号画封装及板边空间 |
| 电机端子 | DEGSON DG500-5.08-03P-14-00A(H) | 5.08 mm，3P 直插 | 1 | [C581322](https://item.szlcsc.com/609123.html) | 国内站核价 |
| 核心板座、编码器座、XT30 线端母头 | 按核心板、模块和电源线实物配对 | 检查高度、方向、线径和外壳型号 | 按实际 | 配对后定号 | 纳入接插件预算 |

有明确小批量美元报价的项目，按一块板及表中最小采购量，已报价采购小计约 **US$18**。分流、SS14、部分电容、普通 RC、保险、配对接插件、PCB、贴装及运费还需单列。Boost 输入/输出、自举、中点分压和缓冲、栅极阻容等按第 3、4 节完整装配，位号数量由 Altium 原理图冻结后导出。可以合并采购常用 SOT-23 与阻容，以减少重复起订。 [驱动器价](https://www.lcsc.com/product-image/C3036056.html) · [MOS 价](https://www.lcsc.com/product-detail/C125865.html) · [采样放大器价](https://www.lcsc.com/product-image/C2058943.html) · [Boost 价](https://www.lcsc.com/product-image/C7722.html) · [XT30 价](https://www.lcsc.com/product-image/C431092.html)

| 可选物料 | 立创编号 | 装配决定 |
|---|---|---|
| RALEC LR2512-21R020F4 | [C304383](https://item.szlcsc.com/288450.html) | 同为 2512 / 20 mΩ / 1% / 1 W，比较库存、温漂和焊盘建议 |
| Vishay WSLT2512R0200FEA | [C844089](https://item.szlcsc.com/903663.html) | 采样电阻备选，按国内报价决定 |
| AS5047P-ATSM | [C962063](https://www.lcsc.com/product-detail/C962063.html) | TSSOP-14。首版用已有 AS5600，升级时优先考虑机械匹配的完整模块 |
| 第二颗电解与制动支路 | 按回灌测试决定 | 先保留焊位，实际制动功率和门限按第 3 节复核 |

芯片按 SOIC、TSSOP、SOT-23 封装落图。MOS 每个焊脚、芯片 Pin 1、XT30 极性均留可见丝印或铜标记。6 层板的大铜皮会带走烙铁热量，焊接前先给焊盘预上锡，XT30 放板边并用机械支撑承受插拔力。焊盘尺寸和热连接以载流需求及器件图纸共同决定。 [资料索引](资料/资料索引.md)

## 7. 从六步换向到 FOC 的实验顺序

### 7.1 台架与电机辨识

| 顺序 | 做法 | 验收 |
|---|---|---|
| 1. 底板不插核心板 | 电机断开、桥禁止，台式电源限流，测 VM、5 V、3.3 V、核心板插座电源针。测试核心板 USB 与底板 5 V 的隔离 | 电压符合规格，MCU_ARM 保持低，静态电流和温升合理 |
| 2. 核心板与桥空载 | 核对 10V_GATE、1.65 V 中点和各路采样，执行自举预充后观察三组 PWM、VGS 与死区。注入 FAULT_OK 故障，核对六路输入关断和 Break 锁存 | 有确定的默认状态和故障锁存。测到的 VGS、VDS 尖峰低于器件限制并留裕量 |
| 3. 电机静态参数 | 测 U–V、V–W、W–U 的线间电阻和电感。电阻优先四线法，或低压小电流法测端子电压、电流。电感记录仪表频率与转子角度 | 三组结果相近。绕组接法未知时保留线间实测值。平衡电机的等效星形相电阻可按线间值的一半建模 |
| 4. 编码器与相序 | 手转做机械角回绕、磁场状态和方向检查。低电流、短时对齐获得电角零位。慢扫电角或手转配合反电动势核对每机械转 7 个电周期 | `θe = wrap(7 × s × θm + θoffset)` 连续一致，方向 `s` 取 ±1。停机再调整相线或方向定义 |
| 5. 台式电源 | 先测出核心板与驱动器启用但未转时的输入电流。首轮限流可从静态输入电流上方约 0.15–0.25 A 开始，根据实际电源和板耗微调 | 输入电源稳定，且独立记录母线输入电流、相峰值和 Iq |

### 7.2 六步换向

DRV8300DPWR 由 H7 经硬件许可逻辑提供 6 路输入。每个扇区一相高侧 PWM、一相下管导通、第三相的高低输入均置低。按第 4.1 节检查悬空相重入时的自举充电，保持低电流起调。下面是一个相序实例。低侧同步续流可在验证非同步波形后再加入。

| 扇区 | 供电相 | 回流相 | 悬空相 |
|---|---|---|---|
| 1 | U | V | W |
| 2 | U | W | V |
| 3 | V | W | U |
| 4 | V | U | W |
| 5 | W | U | V |
| 6 | W | V | U |

1. 先用固定扇区、很低占空比与短通电验证实际栅极状态。换扇区时用定时器预装载和同步更新，确认悬空相的两管都关断。
2. 用短时低电流对齐，再以缓慢电角速度斜坡推进六步。观察抖动、三相波形、相电流和机械转速。
3. 用 AS5600 算电角，通过 60° 扇区换向，实测并修正扇区相位。到 1400 rpm 时电频率约 163 Hz，每个六步扇区约 1.02 ms，传感器延迟会明显改变换向时刻。
4. 如要学习无感六步，每相预留 `100 kΩ / 10 kΩ` 分压、ADC 侧 470 pF–1 nF 可调电容及保护焊位。对悬空相做 PWM 同步采样，选定续流模式和正确的虚拟中点或母线参考，并屏蔽换向后的振铃。无感六步可作为独立实验。 [ST 六步换向算法](https://wiki.st.com/stm32mcu/wiki/STM32MotorControl%3A6-step_Firmware_Algorithm) · [ST 无感六步采样调试](https://wiki.st.com/stm32mcu/wiki/STM32MotorControl%3A6-step_-_Optimization_and_troubleshooting_of_sensor-less_firmware_parameters)

### 7.3 正弦、电流环、速度环与位置环

| 阶段 | 实施 | 观察 |
|---|---|---|
| 正弦开环 | 连续推进电角，低幅值 SPWM 或 SVPWM，设置电压斜坡和相电流监控 | 对照六步的噪声、抖动、波形 |
| 电压模式有感 | 用 AS5600 实际电角参与逆 Park，验证坐标变换方向、电角零位、正负转矩 | 开环电压指令变化时电机响应一致 |
| 电流环 FOC | 硬件触发读相电流 → Clarke → Park → Id/Iq PI → 逆 Park → SVPWM。先用 `Id_ref=0`、小 `Iq_ref`。对电压矢量限幅，线性 SVPWM 的理想相电压矢量上限为 VM_BUS/√3，实际再给采样窗口留裕量，并做 PI 抗饱和 | Id 维持接近 0，Iq 正负随指令，故障时可关断。重点记录采样窗口与编码器样本年龄 |
| 速度环 | 约 200–500 Hz 起步，输出限幅后的 Iq 指令。AS5600 的速度估算要处理 4096 回绕、滤波和时间戳 | 先空载小阶跃，再短时轻载，对照实际母线峰值 |
| 位置环 | 约 50–200 Hz 起步，输出速度指令。连续角度使用软件圈数累加，重新上电时按单圈绝对角重新建立参考 | 小角度往复、位置误差、静止温升和回灌峰值 |

电流 PI 可从等效 RL 模型估算连续参数 `Kp ≈ L × ωc`、`Ki ≈ R × ωc`，其中 `ωc=2πfc`。初始可用 100–200 Hz 电流环带宽做台架起调，根据采样和实际噪声调整。若控制器输出为伏特，离散积分每次乘采样周期，SVPWM 前再按实时母线归一化。若开启 DMA 与 H7 D-Cache，按芯片内存域和一致性规则安排缓冲区。首轮可从 ADC 注入中断开始，测中断周期与执行时间。固件建议自己实现这条链路，ST 的资料用于对照算法和调试方法。 [ST RM0433](https://www.st.com/resource/en/reference_manual/rm0433-stm32h742-stm32h743-753-and-stm32h750-value-line-advanced-armbased-32bit-mcus-stmicroelectronics.pdf) · [ST 电机控制开发参考](https://www.st.com/resource/en/user_manual/um1945-stm32-nucleo-packs--motor-control-foc-and-6step-solutions-for-three-phase-lowvoltage-and-lowcurrent-motors-stmicroe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)

## 8. 定版条件

- [ ] 拿到核心板对应版本原理图，或用原底板图纸和实物核对每个配对针脚。重点确认核心板 5 V、地、方向、6 路 PWM、BKIN 和 ADC。
- [ ] 得到卖家额定及峰值电流，或记录低电流起步的电流、转速和温升并明确允许的台架范围。补齐线间 R/L 与编码器套件针序。
- [ ] 记录台式电源型号、电压电流范围、限流特性和是否能吸收回灌。高惯量、反转或制动测试前先验证能量去路。
- [ ] 实测 5 V 稳压启动、USB/SWD 供电路径、PWM/ADC 同步、过流比较器、10 V 欠压许可、母线过压、GATE_EN 与 Break，保留示波器截图。
- [ ] 先用 AS5600 完成低速六步和 FOC，再用电角度滞后、Id/Iq 波形及最高目标转速决定 SPI 模块的装配。

当前方案可以开始画电源、驱动、采样和保护原理图。核心板连接器脚号、电机工作电流和制动支路参数按上述实物及测量结果收敛。
