csdnaokdm/FOC/审查报告/资料/资料索引.md

# 审查资料索引

本目录存放本次原理图审查所用的手册、图纸截图与数据文件。报告正文在上一级：`../原理图审查报告.md`。

## 一、芯片手册

| 文件 | 器件 | 来源 | 用途 |
|---|---|---|---|
| `TI-LMR51430.pdf` | LMR51430（SLUSEF4A，2022-11 Rev.A，33 页） | TI 原厂，与立创商城 [C5185863 商品页](https://item.szlcsc.com/5856347.html) 提供的手册为同一份 | 引脚定义（P3）、绝对最大值（P4）、基准电压 0.6 V 与限流 3.67 A（P5）、12 V→5 V 参考电路与选型表（P16）、分压计算（P17）、电感/输出电容计算（P18）、布局要求（P21） |
| `AMS1117-AMS.pdf` | AMS1117（Advanced Monolithic Systems，8 页） | [AMS 原厂](http://www.advanced-monolithic.com/pdf/ds1117.pdf) | 引脚定义（P1）、功耗上限 1.2 W / θJA 90 °C/W（P2–P3）、**输出电容 22 µF 稳定性要求（P4）**、热耗计算（P5） |

> 立创商城对应料号：`LMR51430XDDCR` = **C5185863**（SOT-23-6，3 A，4.5–36 V，500 kHz）。
> 原理图 U2（AMS1117-3.3）目前**没有绑定立创料号**，见报告 6.11。

### 手册中与本次结论直接相关的原文

- LMR51430 P3，Table 6-1：
  > "CB — 6 — P — Bootstrap capacitor connection for the high-side FET driver. **Connect a high quality 100-nF capacitor from this pin to the SW pin.**"
- LMR51430 P3：
  > "EN — 5 — A — Precision enable input… **This pin can be tied to VIN.**"
- LMR51430 P16，Figure 9-1 / Table 9-1（12 V→5 V，500 kHz）：
  > L = 6.8 µH，CBOOT = 0.1 µF，CIN = 2.2 µF，COUT = 2×22 µF，RFBT = 100 kΩ，RFBB = 13.7 kΩ
- LMR51430 P17：
  > "Choose the value of RFBB to be 13.7 kΩ. With the desired output voltage set to 5 V and the VREF = 0.6 V, the RFBT value can then be calculated… yields a value 100.4 kΩ. A standard value of 100 kΩ is selected."
- AMS1117 P4，Stability：
  > "The circuit design used in the AMS1117 series **requires the use of an output capacitor** as part of the device frequency compensation. The addition of **22 µF solid tantalum** on the output will ensure stability for all operating conditions."

## 二、图纸图片

| 文件 | 内容 |
|---|---|
| `原理图全页.png` | Power.SchDoc 整页渲染（2000×1324） |
| `原理图预览.png` | 原始预览尺寸（1000×662） |
| `图1_输入与母线电容.png` | CON1、C2/C3 470 µF、C4/C5 100 µF、PGND/VBUS/+12V |
| `图2_5V降压主回路.png` | U1 LMR51430、C6/C7 输入、C1 自举、L1 6.8 µH |
| `图3_反馈分压与输出.png` | R1 100 kΩ / R2 13.7 kΩ 分压、C8/C9 输出 |
| `图4_3V3_LDO.png` | U2 AMS1117-3.3、C10 输入、C11/C12 220 nF 输出 |

> 图片由 `__Previews\Power.SchDocPreview` 中 zlib 压缩的位图还原而来（该预览文件原始方向为上下翻转，已校正）。

## 三、数据文件

| 文件 | 内容 |
|---|---|
| `网表.csv` | 从 SchDoc 解析出的完整网表，41 个引脚 × 网络名 / 位号 / 引脚号 / 引脚名 / 坐标 |

## 四、复现方式

本报告的网络表不是目视读图，而是解析 `Power.SchDoc` 的 OLE 复合文档 → `FileHeader` 记录流（560 条）→ 按引脚 `PinConglomerate` 与 `PinLength` 还原电气热点 → 按端点/节点/端口同名合并连通性。因此“某个引脚有没有接上”“两个网络有没有误连”这类判断是逐引脚枚举得出的，不依赖截图分辨率。

## 五、脚本

全部脚本放在上一级的 [`脚本/`](../脚本/README.md) 目录，可直接重跑（`python netlist.py` 会重新生成 `网表.csv` 和终端里的网络表）：

| 脚本 | 作用 |
|---|---|
| `cfb.py` | OLE 复合文档解析 |
| `schdoc.py` | SchDoc 记录解析 |
| `netlist.py` | 重建网络表 + 连通性体检 + 写 `网表.csv` |
| `components.py` | 导出元件清单与立创料号缺口 |
| `images.py` | 从预览文件还原整页图与 4 张局部图 |
| `download_datasheets.py` | 重新下载本目录的手册 |
