csdnaokdm/FOC/选型报告/资料/资料索引.md

# 资料索引

2026-11-05 更新。当前手焊方案采用 DRV8300DPWR、AO4266、INA181A1、TPS61040 及外部保护逻辑。表内本地文件已检查 PDF 文件头，未取得 PDF 的资料使用官方或商城入口。

| 用途 | 本地文件 / 原始入口 |
|---|---|
| 三相驱动 TSSOP-20 | [DRV8300 本地 PDF](TI-DRV8300.pdf) · [TI 数据手册](https://www.ti.com/lit/ds/symlink/drv8300.pdf) |
| SO-8 MOSFET | [AO4266 本地 PDF](AOS-AO4266.pdf) · [AOS 数据手册](https://www.aosmd.com/res/datasheets/AO4266.pdf) |
| 三路外置电流放大 | [INA181 本地 PDF](TI-INA181.pdf) · [TI 数据手册](https://www.ti.com/lit/ds/symlink/ina181.pdf) |
| 电流中点缓冲 | [TLV9001 本地 PDF](TI-TLV9001.pdf) · [TI 数据手册](https://www.ti.com/lit/ds/symlink/tlv9001.pdf) |
| 六路 PWM 许可 | [SN74LVC08A 本地 PDF](TI-SN74LVC08A.pdf) · [TI 数据手册](https://www.ti.com/lit/ds/symlink/sn74lvc08a.pdf) |
| 栅极供电 Boost | [TPS61040 本地 PDF](TI-TPS61040.pdf) · [TI 数据手册](https://www.ti.com/lit/ds/symlink/tps61040.pdf) |
| 5 V Buck | [LMR51420 本地 PDF](TI-LMR51420.pdf) · [TI 数据手册](https://www.ti.com/lit/ds/symlink/lmr51420.pdf) |
| 3.3 V LDO | [TLV755P 本地 PDF](TI-TLV755P.pdf) |
| 比较器 | [TLV1704 本地 PDF](TI-TLV1704.pdf) |
| 防反接二极管 | [STPS5L60 本地 PDF](ST-STPS5L60.pdf) |
| XT30 电源输入 | [C431092 商品与厂商图纸入口](https://www.lcsc.com/product-detail/C431092.html) · [立创 XT30 图纸入口](https://item.szlcsc.com/datasheet/XT30PW-M30.G.Y/426930.html)。型号 XT30PW-M30.G.Y，板载通孔、卧式出线 |
| 采样电阻 | [大毅商城参数与手册入口](https://item.szlcsc.com/983045.html) · [RALEC 备选](https://item.szlcsc.com/288450.html) |
| TVS | [Littelfuse SMBJ 数据手册](https://www.littelfuse.com/assetdocs/tvs-diodes-smbj-series-datasheet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) |
| AS5600 | [评估板本地 PDF](ams-AS5600-评估板.pdf) · [芯片手册入口](https://look.ams-osram.com/m/7059eac7531a86fd/original/AS5600-DS000365.pdf) |
| AS5047P | [厂商器件页](https://www.infineon.com/part/AS5047P) |
| 阿波罗 H7 | [正点原子阿波罗 V2 官方资料帖](https://www.openedv.com/thread-344988-1-1.html)。核心板自身修订号、针脚及配对连接器按实物对应资料核对 |
| STM32H743 | [ST 数据手册](https://www.st.com/resource/en/datasheet/stm32h743ii.pdf) · [ST RM0433](https://www.st.com/resource/en/reference_manual/rm0433-stm32h742-stm32h743-753-and-stm32h750-value-line-advanced-armbased-32bit-mcus-stmicroelectronics.pdf) |
| 六步换向 | [ST 六步算法](https://wiki.st.com/stm32mcu/wiki/STM32MotorControl%3A6-step_Firmware_Algorithm) |
| 六层工艺与载流 | [嘉立创六层板](https://jlcpcb.com/resources/6-layer-pcbs) · [IPC-2152 温升资料](https://www.ipc.org/system/files/technical_resource/E7%26S22_03.pdf) |

较早版本下载的 TI-DRV832x、DRV8323 评估板、CSD18543Q3A 和 AON7264E PDF 留在资料目录，供器件与架构对照。当前采购以《选型报告.md》v0.4 BOM 为准。
