csdnaokdm/FOC/审查报告/资料/原理图预览.png

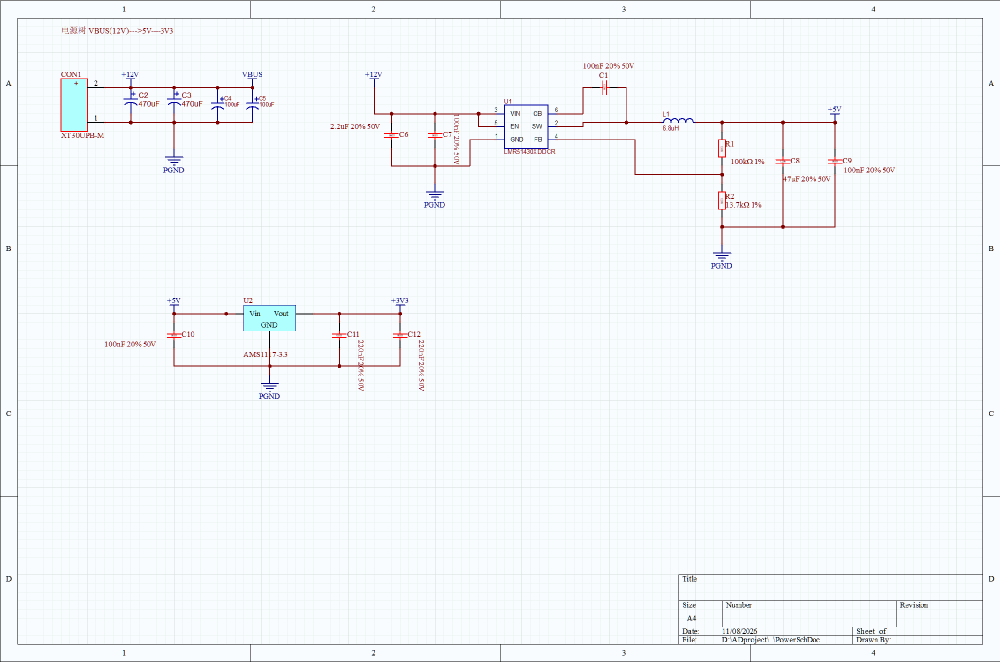
审查报告/资料/原理图预览.png
