csdnaokdm/FOC/(list of files, drawings)

Other design files:
project/FOC/FOC.PcbDoc
project/FOC/FOC.PrjPcb
project/FOC/MOSDriver.SchDoc
project/FOC/port.SchDoc
project/FOC/Power.SchDoc
