csdnaokdm/FOC/(commit log)

2026-11-11 收录 FOC 控制器 Altium 工程与报告
2026-11-12 整理硬件选型报告并补充电容减容与采购信息
    - 按芯片、电容、端子与其他器件整理当前选型
    - 按功能位置列出电容规格、含税价格、起卖量及工作电压下的典型容量
    - 记录两颗1µF输入方案、1210母线滤波选型和原厂曲线证据
    - 补充UMW AMS1117-3.3采购料号及输出钽电容的手册依据
    - 将旧料号对比与原始方案归档，保留历史查阅入口
2026-11-12 同步Altium工程与原理图并清理自动生成文件
    - 更新FOC工程配置及Power、MOSDriver、port三张原理图
    - 补充选型报告资料中的两份原厂网页快照
    - 添加.gitignore，忽略工程History、Project Logs与__Previews目录
    - 从版本管理移除误传的备份、日志和预览缓存，本地保留
2026-11-12 更新电源与驱动原理图并补充电容选型参考
